JimorMarlow/Moonshine/README.md

# Moonshine
Temperature and water flow control

## Оборудование
- Датичики температуры DS18B20
    - (Tank) Температура внутри бака D8 с резьбой 1/2" 
    - (WaterOut) 2x Трехпроводные датчики для измерения температуры воды на выходе
        - df-out, °C
        - condenser-out, °C
    - 
- Датичики Холла для измерения потока воды (пока только счетчик срабатываний за 10с и за 1мин, без учета потока)
    - из дефлегматора (df)
    - из охладителя (condenser)
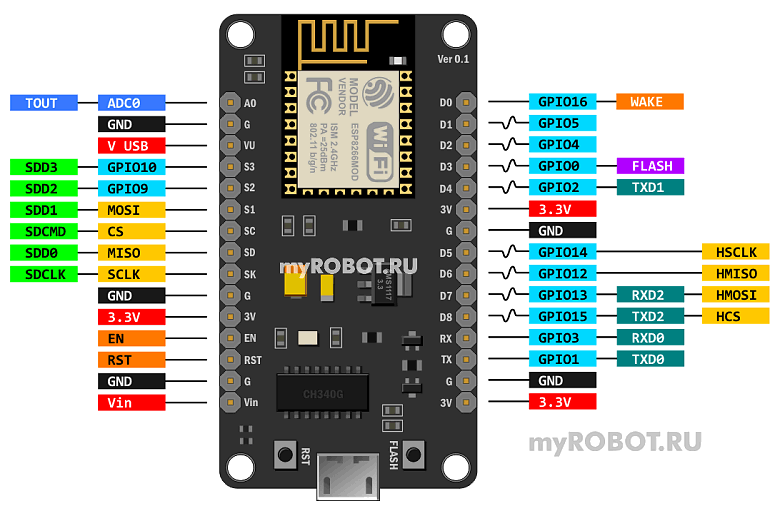
[picture p1: docs/nodemcu_v3_pinout.png]
NodeMCU v3 Pinout
- NodeMCU v3 Pinout <br>
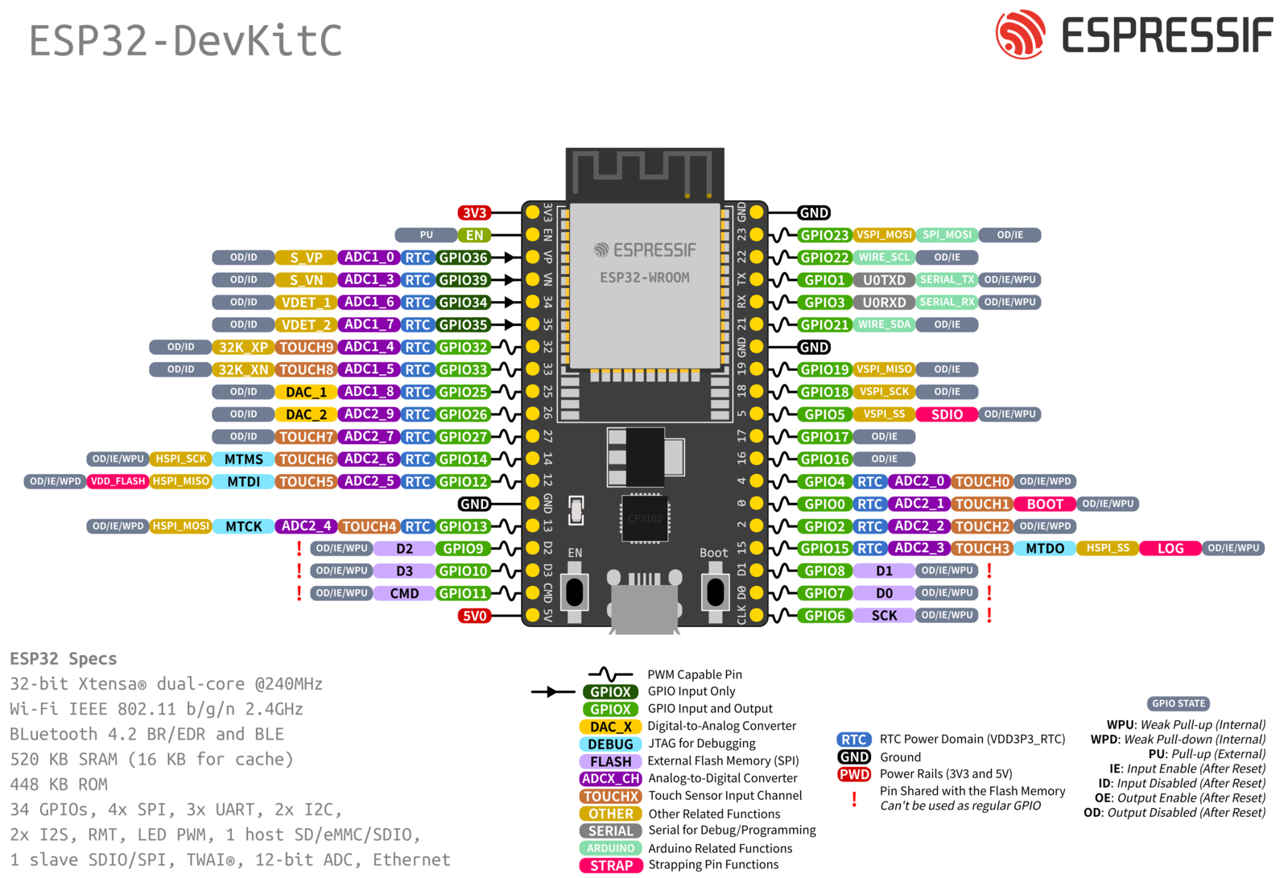
[picture p2: docs/images/eps32U-pinout.png]
ESP32-WROOM-32 Pinout
- ESP32-WROOM-32 Pinout <br>

## Названия переменных
- t_steam — Температура паров в верху колонны (после дефлегматора). Ключевая точка для контроля фракций.
- t_heater — Температура в нагревательном баке (кубе) с исходным материалом.
- t_deflegmator_water_out — Температура воды на выходе из дефлегматора. Показывает эффективность дефлегматора.
- t_condenser_water_out — Температура воды на выходе из охладителя (конденсатора/холодильника). Показывает эффективность конечного охлаждения.
- flow_deflegmator_water — Скорость потока воды через дефлегматор.
- flow_condenser_water — Скорость потока воды через охладитель (конденсатора/холодильника).

## Архитектура проекта
 
Основные компоненты:
ESP32-WROOM-32 (38pin) - взял с запасом, чтобы можно было подклчюить и графический дисплей, но потом оставил так

4 датчика температуры DS18B20 (водонепроницаемые, с цифровым интерфейсом OneWire). Один провод для всех датчиков + питание + земля.

Resistor 4.7kΩ между сигнальным проводом и питанием для подтяжки линии OneWire.

- D4 GPIO04 t_steam
- D5 GPIO05 t_heater
- D18 GPIO18 t_deflegmator_water_out
- D19 GPIO19 t_condenser_water_out

Примечание: не хочется возиться с адресами датчиков и их индексаций, буду подуключать датчики по одному на каждый пин и опрашивать отдельно, чтобы можно спокойно заменять датчики и точно знать, где какой

Для каждого датчика линию данных подтягиваем через 4.7kΩ Resistor к +3.3V
Все датчики на разных входах, чтобы можно было подключать любой датчик без настройки адресов 

### Датчик расхода воды

YF-S201 Не не подошел, слишком грубый.

Был подбран датчик для кофемашин с малыми потоками.
* Water Flow Sensor SEN-HZ06D

// ПРАВИЛЬНО - используем INPUT без дополнительной подтяжки
pinMode(FLOW_SENSOR_PIN, INPUT);  

Адаптация уровней напряжения:
SEN-HZ06D выдает 5V импульсы, а ESP32 работает с 3.3V логикой.
Используем 4-канальый конвертор логических уровней 5V-3V3

### 🔌 Сигнальные пины (GPIO) ESP32

| Пин на ESP32 | GPIO № | Куда идет (Компонент -> Пин) | Назначение / Примечание |
| :--- | :--- | :--- | :--- |
| **D21** | 21 | LCD2004 (`SDA`) | Шина I2C (данные) |
| **D22** | 22 | LCD2004 (`SCL`) | Шина I2C (тактирование) |
| **D15** | 15 | Кнопка (`1.l`) | Вход кнопки. В коде обязательно включить `INPUT_PULLUP` |
| **D4** | 4 | Датчик Steam (`DQ`) | Шина 1-Wire (пар) |
| **D5** | 5 | Датчик Heater (`DQ`) | Шина 1-Wire (нагреватель) |
| **D18** | 18 | Датчик DF (`DQ`) | Шина 1-Wire (дефлегматор) |
| **D19** | 19 | Датчик Cond (`DQ`) | Шина 1-Wire (конденсатор/холодильник) |
| **D32** | 32 | Преобразователь (`LV1`) | Сигнал от датчика потока `flowDF` (после понижения уровня) |
| **D33** | 33 | Преобразователь (`LV2`) | Сигнал от датчика потока `flowCond` (после понижения уровня) |

#### Схема коммутации

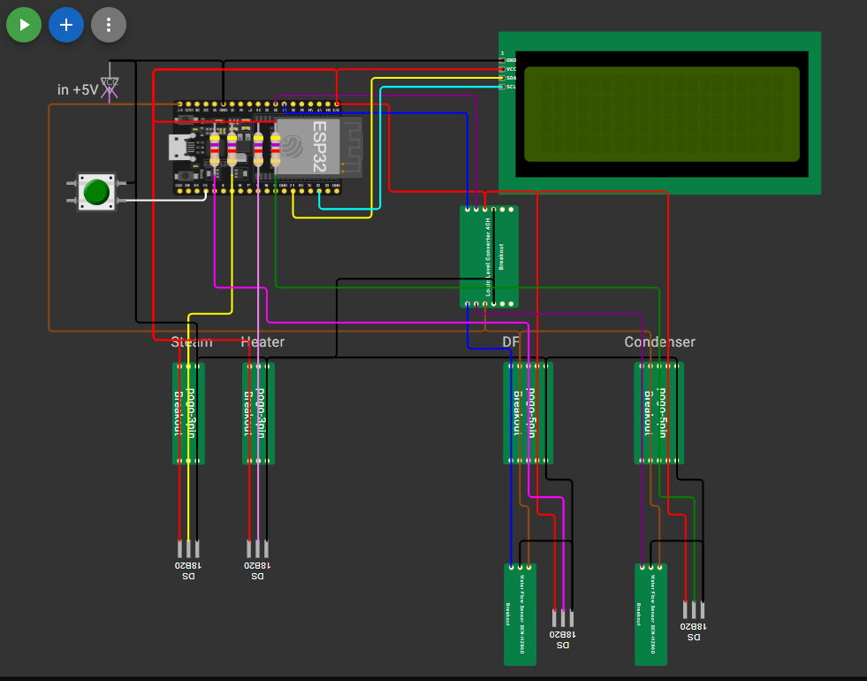
[picture p3: docs/wokwi/wire-esp32-v4.png]
ESP32-WROOM-32 Scheme
- ESP32-WROOM-32 Scheme <br>

### Распиновка контактов

#### 3-pin датчик с сигнальным
Рекомендованная разводка:

text
Разъем XH-2.54 3-pin (вид на плату):
       ┌─────┐
       │  ●  │ 1: GND      (Черный провод)
       │  ●  │ 2: 3V3      (Красный провод)  
       │  ●  │ 3: DATA     (Желтый провод)
       └─────┘
       
На плате (рядом с разъемом):
[GND] [3V3] [DATA]  ← шелкография
На принципиальной схеме:

text
Разъем J1 (DS18B20):
Pin 1: GND
Pin 2: 3V3
Pin 3: TEMP_DATA
5. Как определить правильную ориентацию:
Ключ (polarity key) на разъеме:
text
           ┌─────────┐
           │  КЛЮЧ   │ ← Выступ/защелка
           │   ▼     │
Контакты → │ ●  ●  ● │
           └─────────┘
           
Ключ всегда направлен:
- К началу (пину 1 - GND) ИЛИ
- К концу (пину 3 - DATA)
Распространенное правило: Ключ направлен к пину 1 (GND)

#### Комбирированный pogo 5-pin магнитный разъем для подключения датчика температуры и потока воды (дефлегматор и конденсер)
Магнитный раъъем на корпусе контроллера, снизу разделяется на два 3-pin водозащитных разъема.

Рекомендуемая распиновка для 5-pin магнитного разъема

Вид на разъем (на плате/в схеме):
Позиция датчиков в линии: [Датчик темп.]---[Датчик потока]
                          (ближе к плате)   (дальше)

##### РАЗЪЕМ 5-PIN:
┌─────┬─────┬─────┬─────┬─────┐
│  1  │  2  │  3  │  4  │  5  │
├─────┼─────┼─────┼─────┼─────┤
│ GND │ 3V3 │TEMP │ VCC │FLOW │
│     │     │DATA │(5V) │DATA │
└─────┴─────┴─────┴─────┴─────┘
     ↑     ↑     ↑     ↑     ↑
Общий   Для   Для     Для   Для
GND   DS18B20 DS18B20 Потока Потока

##### Обоснование:
- GND (пин 1) - общая земля для обоих датчиков
- 3V3 (пин 2) - питание температурного датчика DS18B20
- TEMP_DATA (пин 3) - данные температурного датчика
- VCC (пин 4) - питание 5V для датчика потока
- FLOW_DATA (пин 5) - данные датчика потока

##### На плате (PCB Layout):
- Метки шелкографии:
┌─────────────────────┐
│ DEFLEG/COND LINE    │
│  MAGNETIC CONNECTOR │
│                     │
│  1: GND  ⚫         │
│  2: 3V3  🔴         │
│  3: TEMP 🟡         │
│  4: 5V   🟤         │
│  5: FLOW 🔵         │
│                     │
│   ▲ KEY/MAGNET      │
└─────────────────────┘
- Цветовая маркировка проводов в кабеле:

##### Рекомендуемая цветовая схема:
┌─────┬───────┬──────────────┐
│ Пин │ Цвет  │ Назначение   │
├─────┼───────┼──────────────┤
│  1  │Черный │ GND (общий)  │
│  2  │Красный│ 3V3 (темп.)  │
│  3  │Желтый │ TEMP_DATA    │
│  4  │Коричневый│ 5V (поток) │
│  5  │Синий  │ FLOW_DATA    │
└─────┴───────┴──────────────┘

Преимущества:
Логическая группировка - сначала всё для температуры, потом для потока
Безопасность - GND первым, сигналы разделены питанием
Удобство отладки - цвета соответствуют функциям
Защита от ошибок - магнитный разъем + правильная полярность
На плате подпишите:

DEFLEG/COND LINE
[G] [3V] [T] [5V] [F]
▲ магнит/ключ

##### Защита и фильтрация:
На стороне платы (рядом с разъемом):

Добавьте:
- Конденсатор 100nF между 3V3 и GND (для DS18B20)
- Конденсатор 100nF между 5V и GND (для датчика потока)
- Резистор 4.7kΩ: TEMP_DATA → 3V3 (подтяжка OneWire)
- Резистор 10kΩ: FLOW_DATA → 3.3V (подтяжка на стороне ESP)
- Диод 1N4007 на линии 5V (защита от обратной полярности)

На стороне линии (в разветвителе):
В разветвителе добавьте:
- Еще по 100nF конденсатору у каждого датчика
- TVS диод на линии DATA (защита от статики)

## Links
### GyverDS18
https://github.com/GyverLibs/GyverDS18
### Принципиальная схема подключения DS18B20 к ESP8266
https://microkontroller.ru/esp8266-projects/podklyuchenie-datchika-temperatury-ds18b20-k-esp8266/

### Controlling Steam Valve with Arduino and Stepper Motor
https://arduinoexpert.com/controlling-steam-valve-with-arduino-and-stepper-motor/
- ➤ Stepper Motor to DRV8825
- ➤ DRV8825  
- ➤ 12V Power Supply:

### Размеры элементов на монтажной плате с шагом 2.54

- Монтажная плата основная      24x18
- ESP8266 NodeMCU               15x11
- BTN                           6x3
- 10pin cable                   5x2 (+1 во все стороны корпус)
- Конвертор логических уровней 4канала  6x5
- Монтажная плата для датчиков  28x6

### Version
#### 0.0.1
Добавил основу проекта, настроил библиотеки
#### 0.0.2
sensor_t - обвязка вокруг GyverDS18 для опроса датчиков температуры#### 0.#### 0.0.3
#### 0.0.3
Исправил опрос температуры, датчики можно переключать на ходу
#### 0.0.4
Подключил LCD 2004 для вывода температуры и времени работы
Добавил медианный (median3) фильтр для сглаживания температуры и вывожу только 1 знак после запятой.
#### 0.0.5
Изменил пины подключения, допаял колодку подключения;
Пока не работает делить для 5В датчика потока - отключил;
Добавил на S3 сенсорную кнопку для отладки.
Небольшая оптимизация кода и вывода на экран.

#### 0.0.6-0.0.10
- Изменил пины, подобрал все входы. чтобы работали датчики. кнопка запуска калибровки датчиков расхода воды. и не мешало запуску и работе ESP8266&.
- Убрал делители напряжения и поставил 4 канальный согласователь логических уровней 3.3V-5V. Теперь датчик холла нормально работает на 5В и не превышает допустимые уровни.
- Собрал первую рабочую схему с полным набором датчиков в конфигурации:
    - S: температура в верхней части колонны (главный контроль отбора фракций)
    - D: температура и счетчик потока воды на выходе из дефлегматоре (больше для контроля и калибровки модифицированнго YF-S201 датчика). В среднем расход 2 мин/1 л (~30L/min). Можно заменить на YF-S401 - его чувствительности должно хватать без модификаций
    - C: температура и счетчик потока воды на выходе из кондесера. Датчик YF-S401 часто простаивает из-за малого потока (13 мин / 1 л, ~5L/min). Нужен более чувствительный датчик.
    - H: температура в нагревательном баке (контроль мощности плиты)
- Сделал режим калибровки. При нажатии на кнопку оба датчика расхода воды сбрасываются и начинают считать время и количество пульсов датчика Холла. Второе нажатие отключает калибровку и покахывает итоговые результаты. Они нужны для составления таблицы и дальнейшего расчета потока воды на разных скоростях потока воды, чтобы учесть неравномерность работы датчика на малых расходах и индивидуальные особенности конкретного датчика.
- Вся схема собрана на макетной плате и бредборде на перемычках. Продумать реализацию автоматической регулировки игольчатого крана с помощью шагового двигателя. После отладки автоматизации развести плату для чистовой пайки и напечатать модель корпуса.
- Перекоммутировал трубки для воды и расположение игольчатых кранов. чтобы локализовать все в одном месте рядом с расбором воды и освободить место для датчиков.
- Выполнил первую дистиляцию с электронным контролем температуры без аналоговых датчиков;

#### 1.0.x
- Изменил заглавную "C" на строчную "c", чтобы не отвлекало от значений.
- Уменьшил скорость индикатора потока на порядок для более плавной анимации. Возможно, нужно будет еще сделать меньше.
- Купил более чувствительные датчики потока "SEN-HZ06D DC5V Small Size Mini Water Flow Sensor Fluid Flow Meter Switch 0.05-1.5L/min For Coffee Machine", буду добавлять в макет
https://ali.click/ktwszq
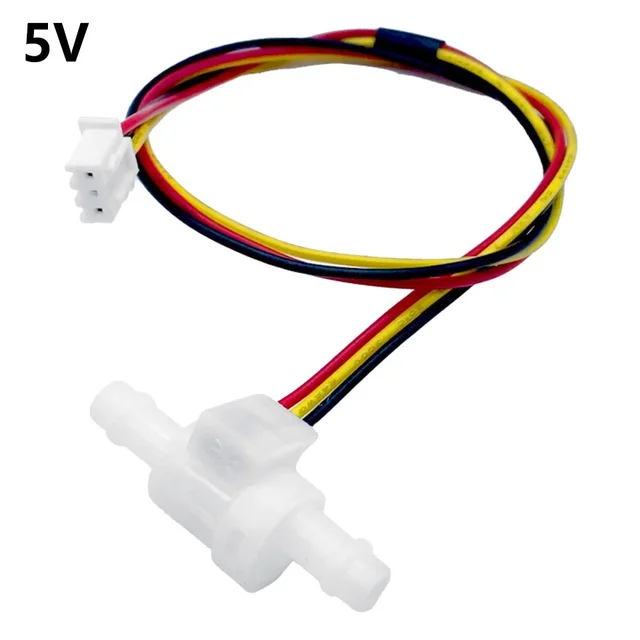
[picture p4: docs/SEN-HZ06D DC5V Small Size Mini Water Flow Sensor Fluid Flow Meter Switch 0.05-1.5L-min.webp]
SEN-HZ06D
<br>
- С помощью qwen 3.5 сделал макет Web-UI для показа текущего состояния [qwen-distillation](docs\web-ui\qwen-distillation.021.html)
- Сделал первый макет разводки PCB платы в EasyEDA. Вместо датчика температуры 3pin и датчика потока 3pin принял решение делать комбинированный pogo 5pin разъем.
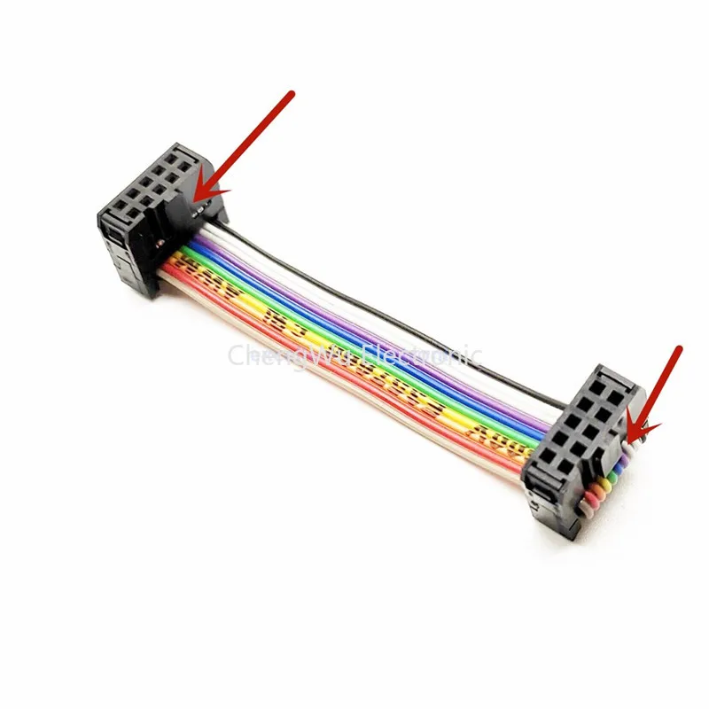
[picture p5: docs/DC3_10p_connector_x2.webp]
DC3_10p_connector_x2
- для соединения основной платы и контактной панели с разъемами для датчиков планирую использовать двойной 10pin шлейф <br>

#### 1.0.31 Добавил макет web-ui с помощью qwen 3.5
Инструкция по установке docs\qwen_install.md

#### 1.1.1 settings::moonshine::state_t
Начал оборачивать все данные в нормальные структуры...

#### 1.2.3 Исправление mDNS
Исправлена работа mDNS для доступа по http://moonshine.local:
- Добавлен вызов `MDNS.update()` в цикле обработки клиентов
- Исправлен порядок инициализации WiFi (hostname до mode)
- Без этого mDNS служба не отвечала на запросы после запуска

#### 1.2.0 Web UI для ESP8266
Добавлен веб-интерфейс для мониторинга процесса дистилляции:
- **Платформа:** ESP8266 (NodeMCU v3)
- **Режимы работы:**
  - Точка доступа (AP): `Moonshine_AP` / `moonshine123`
  - Подключение к Wi-Fi сети (STA)
  - Комбинированный режим (STA+AP)
- **mDNS:** http://moonshine.local (при подключении к Wi-Fi)
- **Обновление данных:** 500ms через AJAX
- **Файлы:**
  - `src/web-ui.h` — объявление веб-сервера
  - `src/web-ui.cpp` — реализация сервера с HTML шаблоном
  - `src/main_ui.cpp` — пример инициализации
- **API:**
  - `GET /` — HTML страница мониторинга
  - `GET /api/state` — JSON с текущими показаниями датчиков
  - `GET /api/status` — JSON со статусом системы (uptime, режим, IP)
- **Данные:** Используются из `settings::moonshine::state_t`
- **Версия веб-интерфейса:** Синхронизирована с `MS_VERSION_STRING` из `version.h`

##### Использование:
```cpp
#include "web-ui.h"

settings::moonshine::state_t get_state(); // Ваша функция получения данных

webui::MoonshineWebServer webServer;

void setup() {
    webServer.setStateGetter(get_state);
    webServer.begin();
}

void loop() {
    webServer.handleClient();
}
```
#### 1.3.1 Переход на ESP32-WROOM - fixes

web-ui - updated to ESP32/ESP8266 compatibility

#### 1.3.0 Переход на ESP32-WROOM

- Заменил чип, чтобы было больше разъемов и можно было подключить графический экран потом с энкодером
- Сделал схему в wokwi https://wokwi.com/projects/478560883984119809
- Схема подключения: 
    - docs\wokwi\wokwi-Moonshine_02.zip
    - docs\wokwi\wire-esp32-v2.png

#### 1.3.- Поменял схему подключения ESP32-WROOM и файл readme.md

На память - информация о подключении графического дисплея
docs\ST7789 320x240 EC11 Rotary Encoder Button.md
