JimorMarlow/Moonshine/docs/cable-pinouts.md

## Цветовая маркировка шлейфа IDC (10 pin / 2x5)

Для 10-контактного шлейфа используется стандартная «радужная» маркировка. Цвета идут в последовательности цветов резисторов, начиная от контакта №1.

### 🎨 Стандартная последовательность цветов

| Маркер | Номер контакта (Pin) | Цвет провода | Подключение |
| :---: | :--- | :--- | :--- |
| 🟤 | **1** | **Коричневый** | 5V |
| 🔴 | **2** | **Красный** | 3V3 |
| 🟠 | **3** | **Оранжевый** | T_STEAM |
| 🟡 | **4** | **Жёлтый** | T_HEATER |
| 🟢 | **5** | **Зелёный** | T_DF |
| 🔵 | **6** | **Синий** | T_CONDENSER |
| 🟣 | **7** | **Фиолетовый** | FLOW_DF |
| <span style="color:#808080">█</span> | **8** | **Серый** | FLOW_CONDENSER |
| ⚪ | **9** | **Белый** | BTN |
| ⚫ | **10** | **Чёрный** | GND |

PS. Вместо серого используется блок, так как серого кружочка нет в Unicode

### 📊 Распределение контактов по рядам (2x5)

В двухрядном разъеме 10-pin контакты нумеруются «змейкой» (нечетные в одном ряду, четные — в другом):

```text
       Ряд 1:  [Pin 1: Коричневый] [Pin 3: Оранжевый] [Pin 5: Зелёный] [Pin 7: Фиолетовый] [Pin 9: Белый]
       Ряд 2:  [Pin 2: Красный]    [Pin 4: Жёлтый]    [Pin 6: Синий]   [Pin 8: Серый]      [Pin 10: Чёрный]
                     ▲
              Метка Pin 1 (ключ / стрелка / треугольник)
```

### 🔍 Как найти Pin 1 (первый контакт)

На корпусе разъема ищите один из следующих маркеров:
1.  **Треугольник** или **стрелку**, выдавленную на пластике.
2.  **Ключ** (выступ) — обычно Pin 1 находится рядом с ним или на стороне, противоположной вырезу.
3.  Если шлейф серый, крайний провод, помеченный **красной полосой**, всегда является Pin 1. В разноцветном шлейфе — это **коричневый** провод.

> ⚠️ **Важно:** При пайке ответного разъема на плату обязательно сверяйтесь с даташитом или шелкографией платы. Иногда производители плат нумеруют контакты построчно (сначала 1-5, затем 6-10), а не «змейкой» (1-3-5 / 2-4-6), как в стандартном разъеме. Внимательная проверка схемы спасет от перепутывания питания и сигнальных линий.
```
