JimorMarlow/Moonshine/docs/ST7789 320x240 EC11 Rotary Encoder Button.md

## Замена LCD2004 на графический дисплей ST7789 320x240 EC11 Rotary Encoder Button

- ST7789 320x240 <br>ST7789+Encoder

https://ali.click/9kmoo1r

На фотографии изображен отличный комбинированный модуль: это цветной дисплей (судя по маркировке пинов и чипу, это 1.8-дюймовый SPI-экран ST7735 или аналогичный), на плате которого уже распаяны инкрементальный энкодер и одна отдельная тактовая кнопка (KEY0).
Это идеальное решение, потому что вся лицевая панель вашего устройства собирается на одной плате, а к вашей основной макетке 5×7 см она будет подключаться всего через один общий 12-пиновый разъем (ряд контактов сверху модуля).
Давайте разберем распиновку этого модуля и схему его подключения к вашей ESP32.

📝 1. Расшифровка пинов модуля (12-pin разъем)

Слева направо (согласно маркировке на фото):
1. GND — Общий минус питания.
2. VDD — Плюс питания (3.3V, так как дисплей и логика ESP32 работают на этом напряжении).
3. SCL — Тактовая частота шины SPI (обычно обозначается как SCK или CLK).
4. SDA — Данные шины SPI (обычно обозначается как MOSI или SDI).
5. RES — Сброс экрана (Reset).
6. DC — Режим Команда/Данные (Data/Command или RS).
7. CS — Выбор чипа экрана (Chip Select).
8. BLK — Управление подсветкой дисплея.
9. TRA — Выход фазы А энкодера (CLK).
10. TRB — Выход фазы В энкодера (DT).
11. PSH — Выход встроенной кнопки энкодера при нажатии (Switch / SW).
12. KEY0 — Выход отдельной тактовой кнопки, расположенной снизу под энкодером.

🗺️ 2. Куда подключать на ESP32 (Новая безопасная карта пинов)

Поскольку шина I2C (D21, D22) от старого LCD2004 полностью освободилась, мы перенаправим её на этот модуль. Для аппаратного SPI используем шину VSPI.
Чтобы не пересекаться с вашими датчиками потока и температуры, подключайте 12-pin разъем к ESP32 по следующей схеме:

Пин модуля	Назначение	Пин на ESP32	Примечание в коде / Настройка
GND	Земля	GND	На общую шину земли платы
VDD	Питание 3.3V	3V3	На общую шину 3.3V
SCL	SPI Clock	D18	Внимание: Перенесите датчик температуры DF (дефлегматор) с D18 на свободный безопасный D2.
SDA	SPI MOSI	D23	Стандартный аппаратный пин VSPI (полностью свободен)
RES	Экран Reset	D22	Свободный пин (бывший I2C SCL)
DC	Экран Data/Cmd	D21	Свободный пин (бывший I2C SDA)
CS	Экран Chip Sel.	D5	Внимание: Перенесите датчик температуры Heater с D5 на свободный безопасный D14.
BLK	Подсветка	3V3	Можно просто припаять к шине 3.3V, чтобы экран горел всегда на 100%.
TRA	Энкодер А	D25	Свободный пин (поддерживает прерывания)
TRB	Энкодер В	D26	Свободный пин (поддерживает прерывания)
PSH	Кнопка энкодера	D27	Свободный пин. В коде настроить как INPUT_PULLUP
KEY0	Нижняя кнопка	D13	Свободный пин. В коде настроить как INPUT_PULLUP

Примечание: Старая отдельная кнопка на D15 из вашей прошлой таблицы остается на своем месте, а кнопка KEY0 на самом модуле дисплея дает вам дополнительный орган управления (например, кнопку "Назад" или "Старт/Стоп").

# Паспорт проекта: Карта подключений ESP32 (38-pin)

Актуальная таблица подключений всех компонентов автоматики с учетом комбинированного SPI-дисплея со встроенным энкодером, независимых датчиков температуры (1-Wire), датчиков потока воды и внешнего управления. 

Все конфликты пинов устранены, шина SPI переведена на аппаратный контроллер `VSPI`, а температурные датчики перенесены на безопасные выводы (`D2`, `D14`).
---

### 📊 Итоговая таблица распиновки ESP32 (38-pin)

| Пин на ESP32 | GPIO № | Куда идет (Компонент -> Пин) | Назначение / Настройка в коде |
| :--- | :---: | :--- | :--- |
| **🔌 Силовые выводы** | | | |
| **5V / VIN** | — | Винтовой клеммник XY301V (`+`) | Вход основного питания платы +5В от сети |
| **3V3** | — | Модуль дисплея (`VDD`), Конвертер (`LV`), Резисторы | Выход встроенного стабилизатора 3.3В для логики |
| **GND** | — | Клеммник (`-`), Дисплей (`GND`), Конвертер (`GND`) | Общая шина заземления схемы (Земля) |
| **🖥️ Интерфейс Дисплея и Энкодера (SPI + GPIO)** | | | |
| **D18** | 18 | Модуль дисплея (`SCL` / SCK) | Шина VSPI (Тактирование экрана) |
| **D23** | 23 | Модуль дисплея (`SDA` / MOSI) | Шина VSPI (Данные экрана) |
| **D22** | 22 | Модуль дисплея (`RES`) | Сброс экрана (`Reset`) |
| **D21** | 21 | Модуль дисплея (`DC`) | Выбор режима Команда/Данные экрана |
| **D5** | 5 | Модуль дисплея (`CS`) | Выбор чипа экрана (`Chip Select`) |
| **D25** | 25 | Модуль дисплея (`TRA`) | Фаза А энкодера (Настройка: `INPUT` + прерывание) |
| **D26** | 26 | Модуль дисплея (`TRB`) | Фаза В энкодера (Настройка: `INPUT` + прерывание) |
| **D27** | 27 | Модуль дисплея (`PSH`) | Встроенная кнопка энкодера (Настройка: `INPUT_PULLUP`) |
| **D13** | 13 | Модуль дисплея (`KEY0`) | Дополнительная кнопка на модуле (Настройка: `INPUT_PULLUP`) |
| **🌡️ Датчики температуры (1-Wire, подтяжка 4.7 кОм к 3.3В)** | | | |
| **D4** | 4 | Датчик Steam (`DQ`) | Температура пара (Пар) |
| **D14** | 14 | Датчик Heater (`DQ`) | Температура нагревателя (Перенесен с D5) |
| **D2** | 2 | Датчик DF (`DQ`) | Температура дефлегматора (Перенесен с D18) |
| **D19** | 19 | Датчик Cond (`DQ`) | Температура конденсатора / холодильника |
| **🌊 Датчики потока воды (Через логический конвертер 5В -> 3.3В)** | | | |
| **D32** | 32 | Конвертер уровней (`LV1`) | Сигнал от датчика потока `flowDF` |
| **D33** | 33 | Конвертер уровней (`LV2`) | Сигнал от датчика потока `flowCond` |
| **🎛️ Внешнее управление** | | | |
| **D15** | 15 | Отдельная выносная кнопка | Основная кнопка управления (Настройка: `INPUT_PULLUP`) |

---

### 💡 Важные примечания для написания прошивки

1. **Библиотека дисплея (ST7735):** 
   Для работы с цветным экраном в среде разработки (Arduino IDE / PlatformIO) используйте официальные библиотеки `Adafruit_GFX.h` и `Adafruit_ST7735.h`. 
   Инициализация в коде выполняется следующим образом:
   ```cpp
   #define TFT_CS   5
   #define TFT_DC  21
   #define TFT_RST 22
   // Пины MOSI (23) и SCK (18) библиотека задействует аппаратно сами
   Adafruit_ST7735 tft = Adafruit_ST7735(TFT_CS, TFT_DC, TFT_RST);
   ```

2. **Плавная работа энкодера:** 
   Чтобы считывать вращение ручки энкодера без рывков и пропусков шагов во время отрисовки интерфейса, используйте библиотеку `Encoder.h` от Paul Stoffregen. Она автоматически повесит обработку сигналов на высокоскоростные аппаратные прерывания пинов `D25` и `D26`.

3. **Управление подсветкой (BLK):** 
   На 12-пиновом разъеме модуля контакт `BLK` припаивается напрямую к силовой шине `3V3`, чтобы подсветка работала постоянно на 100%. Если в будущем вам потребуется программно гасить экран по таймеру или управлять его яркостью, этот провод можно будет перебросить на любой свободный ШИМ-пин ESP32 (например, полностью свободный `D12`).

4. **Датчики DS18B20:** 
   Для работы с температурными датчиками используйте библиотеки `OneWire.h` и `DallasTemperature.h`. В коде под каждый датчик создается свой экземпляр OneWire на соответствующем пине (4, 14, 2, 19).
