JimorMarlow/Moonshine/docs/wokwi/wowki-moonshine.md

# Разработка схемы подключения элементов

https://wokwi.com/projects/478560883984119809

- Замена ESO8266 на ESP32-WROOM-32U

## TODO (DeekSeek)

Раз вы решили подключить всё вручную (что в данном случае — самое надежное решение), я подготовил для вас **пошаговую таблицу подключений** и обновил файл `diagram.json`, добавив внешнее питание.

### 🔌 Обновленный файл `diagram.json` (с внешним питанием)

Замените ваш код на этот. Я добавил источники питания (`vcc5V` и `gnd1`) и разместил их над ESP32. **Я специально удалил массив `"connections"` (оставив только монитор порта), чтобы вы могли соединить всё сами в визуальном редакторе**, кликая от пина к пину.

```json
{
  "version": 1,
  "author": "Anonymous maker",
  "editor": "wokwi",
  "parts": [
    { "type": "wokwi-vcc", "id": "vcc5V", "top": -200, "left": -50, "attrs": { "voltage": "5" } },
    { "type": "wokwi-gnd", "id": "gnd1", "top": -100, "left": -50, "attrs": {} },
    
    { "type": "board-esp32-devkit-c-v4", "id": "esp", "top": 50, "left": 0, "attrs": {} },
    
    { "type": "wokwi-lcd2004", "id": "lcd", "top": -150, "left": 200, "attrs": { "pins": "i2c" } },
    { "type": "wokwi-pushbutton", "id": "btn1", "top": -150, "left": -200, "attrs": { "color": "yellow", "xray": "1" } },
    { "type": "chip-logic-level-converter", "id": "level", "top": 50, "left": 350, "attrs": {} },
    
    { "type": "wokwi-ds18b20", "id": "tempSteam", "top": 200, "left": -250, "attrs": {} },
    { "type": "wokwi-resistor", "id": "resSteam", "top": 200, "left": -180, "rotate": 90, "attrs": { "value": "4.7k" } },
    
    { "type": "wokwi-ds18b20", "id": "tempHeater", "top": 300, "left": -250, "attrs": {} },
    { "type": "wokwi-resistor", "id": "resHeater", "top": 300, "left": -180, "rotate": 90, "attrs": { "value": "4.7k" } },
    
    { "type": "wokwi-ds18b20", "id": "tempDF", "top": 200, "left": 150, "attrs": { "deviceID": "DF" } },
    { "type": "wokwi-resistor", "id": "resDF", "top": 200, "left": 80, "rotate": 90, "attrs": { "value": "4.7k" } },
    
    { "type": "wokwi-ds18b20", "id": "tempCond", "top": 300, "left": 150, "attrs": { "deviceID": "Condenser" } },
    { "type": "wokwi-resistor", "id": "resCond", "top": 300, "left": 80, "rotate": 90, "attrs": { "value": "4.7k" } },
    
    { "type": "chip-flow-sensor", "id": "flowDF", "top": 200, "left": 400, "attrs": {} },
    { "type": "chip-flow-sensor", "id": "flowCond", "top": 350, "left": 400, "attrs": {} }
  ],
  "connections": [
    [ "esp:TX", "$serialMonitor:RX", "", [] ],
    [ "esp:RX", "$serialMonitor:TX", "", [] ]
  ],
  "dependencies": {}
}
```

---

### 📋 Таблица подключений (для ручной сборки)

В Wokwi, чтобы соединить провода, нужно **кликнуть по пину** одного компонента, а затем **кликнуть по пину** другого. Цвет провода появится автоматически (или его можно поменять, кликнув на него).

Обратите внимание: земля (`GND`) у нас теперь общая. На схеме это компонент `gnd1`. Питание `5V` для силовой части идет от `vcc5V`.

#### 1. Питание ESP32 (Внешнее)
*Чтобы ESP32 запитался от нашего блока питания.*
* `vcc5V` (пин **VCC**) ↔ `esp` (пин **5V**)
* `gnd1` (пин **GND**) ↔ `esp` (пин **GND.1**)

#### 2. Дисплей LCD2004
* `esp` (пин **3V3**) ↔ `lcd` (пин **VCC**)
* `gnd1` (пин **GND**) ↔ `lcd` (пин **GND**)
* `esp` (пин **D21**) ↔ `lcd` (пин **SDA**)
* `esp` (пин **D22**) ↔ `lcd` (пин **SCL**)

#### 3. Кнопка (BTN)
* `esp` (пин **D15**) ↔ `btn1` (пин **1.l**)
* `gnd1` (пин **GND**) ↔ `btn1` (пин **2.l**)

#### 4. Датчики температуры (DS18B20) — *все 4 штуки*
*Будьте внимательны: для каждого датчика нужно 5 соединений (включая резистор).*
**Датчик Steam (Пар):**
* `esp` (пин **3V3**) ↔ `tempSteam` (пин **VCC**)
* `gnd1` (пин **GND**) ↔ `tempSteam` (пин **GND**)
* `esp` (пин **D4**) ↔ `tempSteam` (пин **DQ**) ↔ `resSteam` (пин **2**)
* `esp` (пин **3V3**) ↔ `resSteam` (пин **1**)

**Датчик Heater (Нагреватель):**
* `esp` (пин **3V3**) ↔ `tempHeater` (пин **VCC**)
* `gnd1` (пин **GND**) ↔ `tempHeater` (пин **GND**)
* `esp` (пин **D5**) ↔ `tempHeater` (пин **DQ**) ↔ `resHeater` (пин **2**)
* `esp` (пин **3V3**) ↔ `resHeater` (пин **1**)

**Датчик DF (Дефлегматор):**
* `esp` (пин **3V3**) ↔ `tempDF` (пин **VCC**)
* `gnd1` (пин **GND**) ↔ `tempDF` (пин **GND**)
* `esp` (пин **D18**) ↔ `tempDF` (пин **DQ**) ↔ `resDF` (пин **2**)
* `esp` (пин **3V3**) ↔ `resDF` (пин **1**)

**Датчик Cond (Конденсатор):**
* `esp` (пин **3V3**) ↔ `tempCond` (пин **VCC**)
* `gnd1` (пин **GND**) ↔ `tempCond` (пин **GND**)
* `esp` (пин **D19**) ↔ `tempCond` (пин **DQ**) ↔ `resCond` (пин **2**)
* `esp` (пин **3V3**) ↔ `resCond` (пин **1**)

#### 5. Преобразователь уровней (Logic Level Converter)
*Для него нужно два питания: 3.3В (низкая сторона) и 5В (высокая сторона).*
* `vcc5V` (пин **VCC**) ↔ `level` (пин **HV**) — *силовое питание*
* `esp` (пин **3V3**) ↔ `level` (пин **LV**) — *логическое питание*
* `gnd1` (пин **GND**) ↔ `level` (пин **GND1**)
* `gnd1` (пин **GND**) ↔ `level` (пин **GND2**) *(если у чипа два пина GND)*

#### 6. Датчики потока (Flow Sensors)
*Обратите внимание: они питаются от 5В!*
**Датчик flowDF:**
* `vcc5V` (пин **VCC**) ↔ `flowDF` (пин **VCC**)
* `gnd1` (пин **GND**) ↔ `flowDF` (пин **GND**)
* `flowDF` (пин **SIG**) ↔ `level` (пин **HV1**) — *сигнал на высокую сторону*
* `esp` (пин **D32**) ↔ `level` (пин **LV1**) — *сигнал на низкую сторону*

**Датчик flowCond:**
* `vcc5V` (пин **VCC**) ↔ `flowCond` (пин **VCC**)
* `gnd1` (пин **GND**) ↔ `flowCond` (пин **GND**)
* `flowCond` (пин **SIG**) ↔ `level` (пин **HV2**) — *сигнал на высокую сторону*
* `esp` (пин **D33**) ↔ `level` (пин **LV2**) — *сигнал на низкую сторону*

---
**Совет по сборке:** Начните с подключения земли (`gnd1`) ко всем компонентам, у которых есть GND (LCD, кнопка, датчики температуры, преобразователь, датчики потока). Затем разведите питание (3.3В на слаботочку, 5В на датчики потока и HV-часть). И в самом конце подключите сигнальные провода (D4, D5, D15, D18, D19, D21, D22, D32, D33). Так вы точно ничего не перепутаете!

## Схема подключения

2026-10-22
- docs\wokwi\wokwi-Moonshine_02.zip
- docs\wokwi\wire-esp32-v2.png

## esp32 pinout

Вот подробная таблица подключений, привязанная конкретно к выводам вашей платы ESP32 (DevKit C V4). 

Я добавил колонку с **номером GPIO**, так как в коде прошивки (в Arduino IDE) вы будете обращаться к пинам именно по этим номерам, а не по буквам `Dxx`.

### ⚡ 1. Питание и Земля (Power & Ground)

| Пин на ESP32 | Куда идет | Описание |
| :--- | :--- | :--- |
| **5V** (или VIN) | `vcc5V` (блок питания) | Вход внешнего питания 5В. Отсюда же питаются датчики потока и HV-часть преобразователя. |
| **3V3** | LCD (`VCC`), Датчики t (`VCC`), Преобразователь (`LV`), Резисторы (`1`) | Выход стабилизатора ESP32 (3.3В). Питает слаботочную логику и датчики температуры. |
| **GND.1** | Все компоненты (`GND`) | Общая земля. Рекомендую соединить все земли именно с этим пином (или с внешним `gnd1`). |

---

### 🔌 2. Сигнальные пины (GPIO)

| Пин на ESP32 | GPIO № | Куда идет (Компонент -> Пин) | Назначение / Примечание |
| :--- | :--- | :--- | :--- |
| **D21** | 21 | LCD2004 (`SDA`) | Шина I2C (данные) |
| **D22** | 22 | LCD2004 (`SCL`) | Шина I2C (тактирование) |
| **D15** | 15 | Кнопка (`1.l`) | Вход кнопки. В коде обязательно включить `INPUT_PULLUP` |
| **D4** | 4 | Датчик Steam (`DQ`) | Шина 1-Wire (пар) |
| **D5** | 5 | Датчик Heater (`DQ`) | Шина 1-Wire (нагреватель) |
| **D18** | 18 | Датчик DF (`DQ`) | Шина 1-Wire (дефлегматор) |
| **D19** | 19 | Датчик Cond (`DQ`) | Шина 1-Wire (конденсатор/холодильник) |
| **D32** | 32 | Преобразователь (`LV1`) | Сигнал от датчика потока `flowDF` (после понижения уровня) |
| **D33** | 33 | Преобразователь (`LV2`) | Сигнал от датчика потока `flowCond` (после понижения уровня) |

---

### 💡 Полезная шпаргалка для кода

Когда будете писать код, объявление пинов будет выглядеть примерно так:

```cpp
// Дисплей и кнопка
#define I2C_SDA 21
#define I2C_SCL 22
#define BTN_PIN 15 // Не забыть pinMode(BTN_PIN, INPUT_PULLUP);

// Датчики температуры (1-Wire)
#define TEMP_STEAM_PIN 4
#define TEMP_HEATER_PIN 5
#define TEMP_DF_PIN 18
#define TEMP_COND_PIN 19

// Датчики потока (прерывания)
#define FLOW_DF_PIN 32
#define FLOW_COND_PIN 33
```

**Важный нюанс по датчикам потока (D32, D33):** 
Эти пины отлично подходят для чтения импульсов, так как поддерживают аппаратные прерывания (interrupts). В коде вы сможете использовать `attachInterrupt(digitalPinToInterrupt(FLOW_DF_PIN), pulseCounterFunction, RISING);`, чтобы точно считать частоту вращения крыльчатки без пропусков.

🧮 Рекомендуемая распиновка разъема JTAG-10P

Чтобы минимизировать перекрещивание дорожек на плате и сделать шлейф безопасным (разнести питание и данные), используйте следующую карту пинов для разъема 2×5:

Пин разъема	Сигнал (Цвет / Датчик)	Куда вести дорожку на макетке
Пин 1	GND (Черный)	На общую шину GND платы
Пин 2	3V3 (Красный)	На общую шину 3.3V (питание DS18B20)
Пин 3	5V (Коричневый)	На общую шину 5V от DC-IN (питание датчиков потока)
Пин 4	Кнопка (Белый)	На пин D15 верхней планки ESP32
Пин 5	Датчик Steam (D4)	На пин D4 верхней планки ESP32 (+ к его резистору)
Пин 6	Датчик Heater (D5)	На пин D5 верхней планки ESP32 (+ к его резистору)
Пин 7	Датчик DF (D18)	На пин D18 верхней планки ESP32 (+ к его резистору)
Пин 8	Датчик Cond (D19)	На пин D19 верхней планки ESP32 (+ к его резистору)
Пин 9	Датчик потока flowDF	На пин HV1 конвертера уровней
Пин 10	Датчик потока flowCond	На пин HV2 конвертера уровней
