JimorMarlow/Moonshine/docs/web-ui/errors/screenshot_028.png

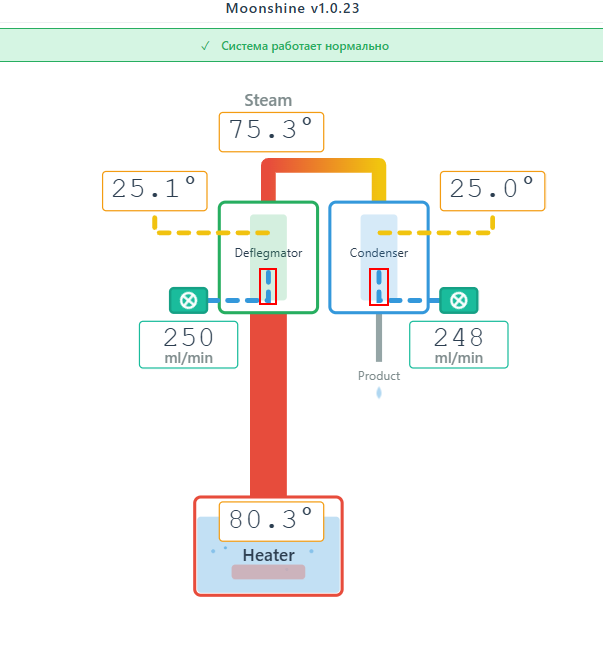
docs/web-ui/errors/screenshot_028.png
