JimorMarlow/Moonshine/docs/wokwi/wire-esp32-v2.png

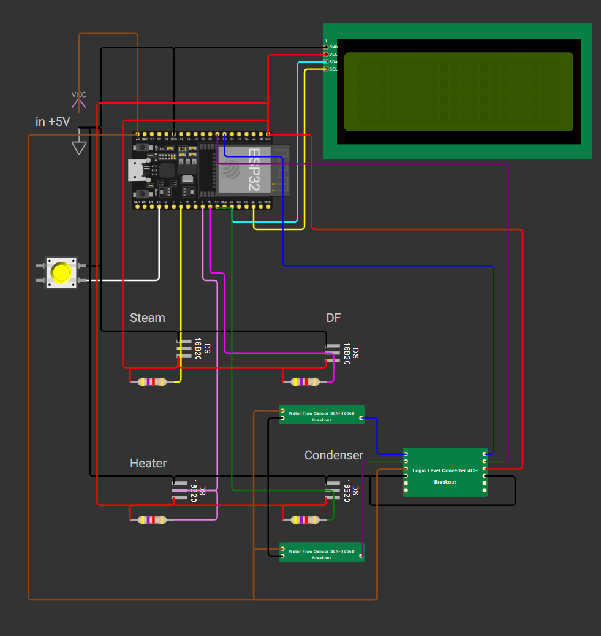
docs/wokwi/wire-esp32-v2.png
