JimorMarlow/Moonshine/docs/wokwi/wire-esp32-v3.png

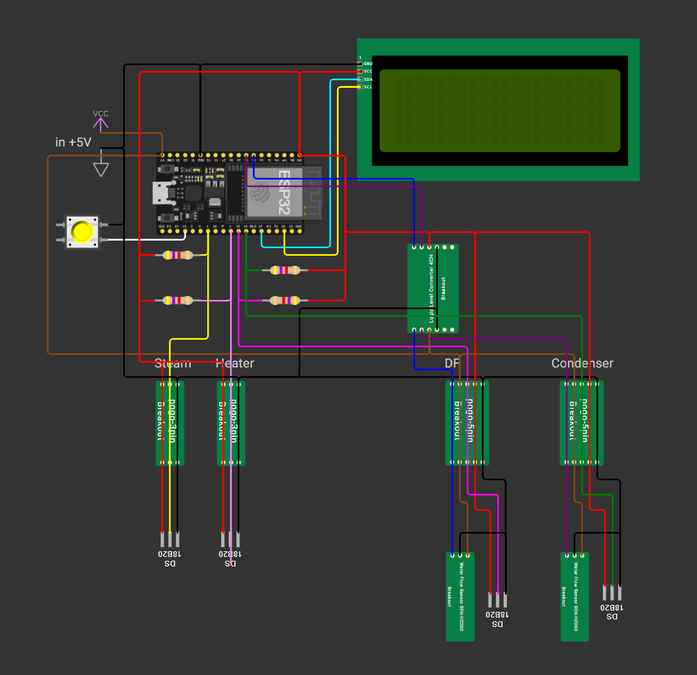
docs/wokwi/wire-esp32-v3.png
