JimorMarlow/Moonshine/docs/OpenSCAD/end-cap-20x10_v1.stl

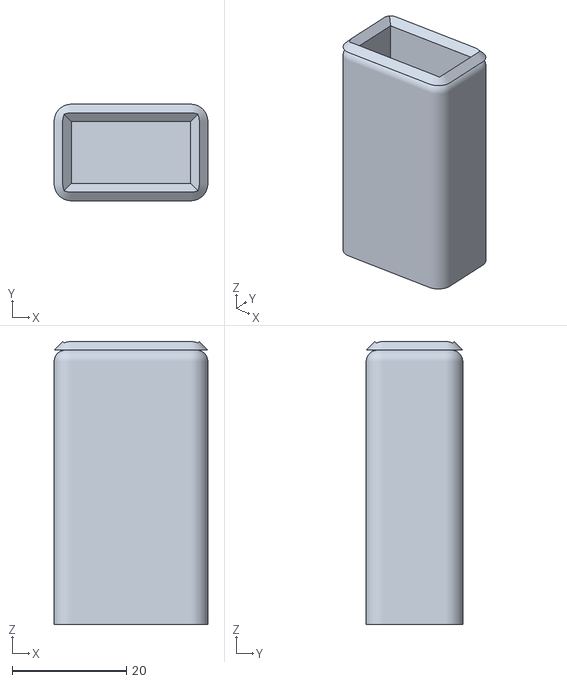
[picture p9: CAD file, 2026-10-28]
docs/OpenSCAD/end-cap-20x10_v1.stl
26.9 x 16.9 x 49.5
