JimorMarlow/Moonshine/docs/OpenSCAD/flow-sensor-adpter-6-8mm.stl

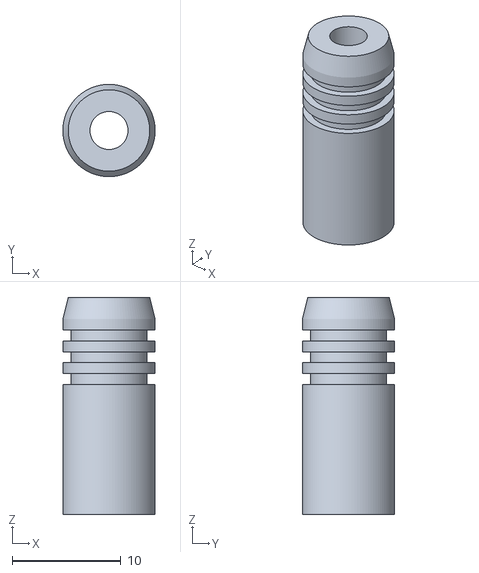
[picture p10: CAD file, 2026-10-27]
docs/OpenSCAD/flow-sensor-adpter-6-8mm.stl
8.50 x 8.50 x 20.0
