JimorMarlow/Moonshine/docs/web-ui/task_wifi_setup_design.md

# WiFi Setup Page — Техническое задание

**Версия:** ESP Device v1.0.0

## Описание задачи

Разработать веб-интерфейс для первичной настройки WiFi подключения устройства на базе ESP8266/ESP32.

## Контекст

Устройство имеет два режима работы:
1. **Режим настройки (Setup Mode)** — точка доступа с именем `ESP_Device_AP` для первичной конфигурации
2. **Рабочий режим (Station Mode)** — подключение к домашней WiFi сети с доступом по mDNS `espdevice.local`

## Требования к дизайну

### 1. Контейнер информации об устройстве (Device Info Container)

**Расположение:** Вверху страницы, под заголовком "WiFi Setup"

**Структура:**
- Горизонтальный контейнер с иконкой слева и текстом справа
- Высота: ~80-100px
- Фон: #F2F2F7 (светло-серый, как в iOS)
- Закругление углов: 12px
- Внутренние отступы: 16px

**Элементы:**

1. **Иконка устройства (слева):**
   - Размер: 48×48 или 56×56px
   - SVG изображение
   - По умолчанию: схематический образ умного устройства для дома
   - Референс: `docs/web-ui/icon_smart_device.svg`
   - Цвет: #007AFF (синий iOS) или градиент
   - Передаётся пользователем через конфигурацию

2. **Название устройства (справа, сверху):**
   - Шрифт: 20px, Bold (700)
   - Цвет: #1C1C1E
   - Пример: "ESP Device v1.x.x"

3. **Описание устройства (справа, под названием):**
   - Шрифт: 15px, Regular (400)
   - Цвет: #8E8E93
   - Пример: "Устройство для умного дома на базе ESP8266/ESP32"
   - Передаётся пользователем через конфигурацию

**Конфигурация (JavaScript):**
```javascript
window.deviceConfig = {
    version: 'ESP Device v1.0.0',           // Название устройства
    description: 'Устройство для умного дома на базе ESP8266/ESP32',  // Описание
    iconSvg: '<svg>...</svg>'               // SVG иконка (опционально)
};
```

**Если иконка не передана:**
- Отображать иконку по умолчанию (схематический умный дом)
- SVG код генерируется автоматически

**Адаптивность:**
- На мобильных: иконка 40×40px, шрифты уменьшаются на 10%
- Контейнер остаётся горизонтальным

---

## Функциональные требования

### 1. Режимы работы

#### 1.1 Режим по умолчанию (AP Mode)
- При первом запуске или после сброса настроек устройство создаёт точку доступа
- **SSID:** `ESP_Device_AP`
- **Пароль:** `password123`
- **IP адрес:** `192.168.4.1`
- Веб-сервер доступен по адресу `http://192.168.4.1`
- **Редактирование:** пользователь может изменить SSID и пароль точки доступа до сохранения настроек

#### 1.2 Сброс к заводским настройкам
- Специальная кнопка (GPIO) удерживается при загрузке устройства (3-5 секунд)
- После сброса:
  - WiFi настройки очищаются
  - Устройство запускается в режиме точки доступа (п. 1.1)
  - Страница настройки WiFi доступна сразу после загрузки

#### 1.3 Рабочий режим (STA Mode)
- После успешной настройки устройство подключается к выбранной пользователем WiFi сети
- Веб-сервер доступен по:
  - mDNS: `http://espdevice.local`
  - IP адресу, выданному роутером

### 2. Страница настройки WiFi

#### 2.1 Основной функционал

1. **Сканирование доступных сетей**
   - Отображение списка обнаруженных WiFi сетей
   - Показывать: SSID, уровень сигнала (RSSI), тип защиты (WPA/WPA2/Open)
   - Сортировка по уровню сигнала (убывание)

2. **Выбор сети**
   - Клик по SSID для выбора
   - Автоматическое заполнение поля SSID
   - Индикация выбранной сети

3. **Ввод пароля**
   - Поле ввода пароля с возможностью показать/скрыть
   - Валидация: минимальная длина 8 символов
   - Для открытых сетей поле пароля скрыто

4. **Подключение**
   - Кнопка "Connect" / "Подключиться"
   - Индикация процесса подключения (анимация/прогресс)
   - Проверка успешности подключения
   - При ошибке — возврат к выбору сети

5. **Настройка точки доступа (AP Mode)**
   - Поля для редактирования SSID и пароля точки доступа
   - Валидация: SSID мин. 1 символ, пароль мин. 8 символов
   - Кнопка "Apply AP Settings" / "Применить настройки AP"

6. **Сохранение и перезагрузка**
   - Кнопка "Save & Reboot" / "Запомнить и перезапустить" (внизу страницы)
   - Сохранение настроек в энергонезависимой памяти (SPIFFS/LittleFS/EEPROM)
   - Перезагрузка устройства после сохранения
   - Редирект на страницу статуса через 10 секунд

#### 2.2 Сброс настроек

- Кнопка "Factory Reset" / "Сброс настроек" в нижней части страницы
- Подтверждение сброса (modal dialog)
- После сброса:
  - Очистка сохранённых WiFi настроек
  - Перезагрузка в режиме точки доступа
  - Возврат на эту же страницу настройки

#### 2.3 Статус подключения

- Индикация текущего статуса:
  - 🔴 Disconnected — не подключено
  - 🟡 Connecting... — подключение
  - 🟢 Connected — подключено, показывать SSID и IP
- Кнопка "Refresh" / "Обновить" для повторного сканирования

### 3. Требования к дизайну

#### 3.1 Общие требования

- **Стиль:** строгий минимализм, в стиле iPhone (iOS Human Interface Guidelines)
- **Фон:** белый (#FFFFFF)
- **Цветовая схема:**
  - Основной текст: #1C1C1E (почти чёрный)
  - Вторичный текст: #8E8E93 (серый)
  - Акцентный цвет: #007AFF (синий iOS)
  - Успех: #34C759 (зелёный)
  - Ошибка: #FF3B30 (красный)
  - Границы: #C6C6C8 (светло-серый)

#### 3.2 Типографика

- **Шрифт:** системный (SF Pro Display для iOS, Roboto для Android, Segoe UI для Windows)
- **Заголовок:** 24px, Bold
- **Подзаголовок:** 17px, Regular
- **Основной текст:** 17px, Regular
- **Вторичный текст:** 15px, Regular
- **Кнопки:** 17px, Semibold

#### 3.3 Макет

- **Ориентация:** вертикальная (mobile-first)
- **Ширина:** адаптивная, 100% ширины экрана
- **Отступы:** 16px по краям, 20px между секциями
- **Высота:** прокручиваемая, контент центрирован

#### 3.4 Компоненты

1. **Header (верхняя панель)**
   - Заголовок: "WiFi Setup" / "Настройка WiFi"
   - Переключатель языка: EN / RU (справа)

2. **Список сетей**
   - Карточки с закруглёнными углами (border-radius: 10px)
   - Тень: 0 2px 8px rgba(0,0,0,0.08)
   - Иконка сигнала (Unicode: 📶) с индикатором уровня
   - Иконка замка для защищённых сетей (Unicode: 🔒 / 🔓)

3. **Поля ввода**
   - Стиль iOS: с закруглёнными углами
   - Высота: 44px (стандарт iOS)
   - Border: 1px solid #C6C6C8
   - Focus: border-color #007AFF

4. **Кнопки**
   - Основная (Save & Reboot): синяя (#007AFF), белый текст
   - Вторичная (Refresh): прозрачная с синей рамкой
   - Опасная (Factory Reset): красная (#FF3B30), белый текст
   - Высота: 44px, border-radius: 10px

5. **Индикаторы**
   - Прогресс подключения: анимированный spinner или progress bar
   - Статус: цветные точки (🔴🟡🟢) + текст

#### 3.5 Unicode иконки

| Элемент | Unicode | Описание |
|---|---|---|
| WiFi сигнал | 📶 | U+1F4F6 |
| Замок (закрыто) | 🔒 | U+1F512 |
| Замок (открыто) | 🔓 | U+1F513 |
| Обновить | 🔄 | U+1F504 |
| Успех | ✅ | U+2705 |
| Ошибка | ❌ | U+274C |
| Предупреждение | ⚠️ | U+26A0 |
| Настройки | ⚙️ | U+2699 |
| Перезагрузка | 🔄 | U+1F504 |

### 4. Языковая локализация

#### 4.1 Структура

- Два языка: **English** (по умолчанию) и **Русский**
- Переключатель в header (справа): EN / RU
- Все тексты интерфейса переводятся
- Сохранение выбора языка в localStorage браузера

#### 4.2 Словарь

| Ключ | English | Русский |
|---|---|---|
| title | WiFi Setup | Настройка WiFi |
| version_label | ESP Device | ESP Device |
| scan_btn | Scan Networks | Сканировать сети |
| refresh_btn | Refresh | Обновить |
| select_network | Select Network | Выберите сеть |
| password_label | Password | Пароль |
| password_placeholder | Enter password | Введите пароль |
| show_password | Show | Показать |
| hide_password | Hide | Скрыть |
| connect_btn | Connect | Подключиться |
| ap_settings_title | Access Point Settings | Настройки точки доступа |
| ap_ssid_label | AP SSID | SSID точки доступа |
| ap_password_label | AP Password | Пароль точки доступа |
| apply_ap_settings_btn | Apply AP Settings | Применить настройки AP |
| save_reboot_btn | Save & Reboot | Запомнить и перезапустить |
| factory_reset_btn | Factory Reset | Сброс настроек |
| status_disconnected | Disconnected | Не подключено |
| status_connecting | Connecting... | Подключение... |
| status_connected | Connected | Подключено |
| confirm_reset | Are you sure you want to reset to factory settings? | Вы уверены, что хотите сбросить настройки к заводским? |
| cancel | Cancel | Отмена |
| confirm | Confirm | Подтвердить |
| success_saved | Settings saved! Rebooting... | Настройки сохранены! Перезагрузка... |
| error_connection | Connection failed. Check password. | Ошибка подключения. Проверьте пароль. |
| no_networks | No networks found | Сети не найдены |
| signal_excellent | Excellent | Отличный |
| signal_good | Good | Хороший |
| signal_weak | Weak | Слабый |
| signal_very_weak | Very Weak | Очень слабый |

### 5. Технические требования

#### 5.1 Фронтенд

- **HTML5** с семантической разметкой
- **CSS3** с Flexbox/Grid для макета
- **Vanilla JavaScript** (без фреймворков для минимизации размера)
- **Fetch API** для AJAX запросов
- **localStorage** для сохранения выбора языка
- **Single Page Application** подход (без перезагрузки страниц)

#### 5.2 Бэкенд (ESP8266/ESP32)

- **HTTP сервер:** ESP8266WebServer / WebServer
- **API endpoints:**
  - `GET /` — страница настройки
  - `GET /api/scan` — сканирование сетей (JSON)
  - `POST /api/connect` — подключение к сети (JSON)
  - `GET /api/status` — статус подключения (JSON)
  - `POST /api/save` — сохранение настроек (JSON)
  - `POST /api/reset` — сброс настроек (JSON)
  - `POST /api/ap_settings` — настройка точки доступа (JSON)
- **Хранение данных:**
  - SPIFFS/LittleFS для HTML/CSS/JS файлов
  - EEPROM или Preferences для WiFi настроек
- **mDNS:** для доступа по имени в рабочем режиме

#### 5.2.1 Структура конфигурации (для библиотеки ETL)

**Файл:** `src/etl_wifi_setup.h`

```cpp
namespace etl::wifi {
    struct server_config_t {
        String hostname = "espdevice";              // Имя хоста для mDNS
        String ap_ssid = "ESP_Device_AP";           // SSID точки доступа по умолчанию
        String ap_password = "password123";         // Пароль точки доступа по умолчанию
        String sta_ssid = "";                       // SSID внешней сети (пусто = не подключено)
        String sta_password = "";                   // Пароль внешней сети
        uint16_t port = 80;                         // Порт веб-сервера
        uint32_t update_interval = 500;             // Интервал обновления данных (мс)
    };

    struct scan_result_t {
        String ssid;                                // SSID сети
        int32_t rssi;                               // Уровень сигнала (dBm)
        String encryption;                          // Тип шифрования (WPA2, WPA, Open)
        uint8_t channel;                            // Канал
    };

    enum class connection_status_t {
        disconnected,                               // Не подключено
        connecting,                                 // Подключение
        connected,                                  // Подключено
        error                                       // Ошибка
    };

    class wifi_setup {
    public:
        explicit wifi_setup(const server_config_t& cfg = server_config_t());
        virtual ~wifi_setup();

        virtual bool begin();                       // Инициализация WiFi сервера
        virtual void stop();                        // Остановка и освобождение ресурсов
        virtual void handle();                      // Основной цикл обработки

        virtual bool is_initialized() const;        // Проверка инициализации
        virtual connection_status_t get_connection_status() const;
        virtual bool is_connected() const;

        virtual String get_ip_address() const;
        virtual String get_mode() const;

        virtual int32_t scan_networks(std::vector<scan_result_t>& results);
        virtual bool connect_to_network(const String& ssid, const String& password, uint32_t timeout = 10000);
        virtual void disconnect();

        virtual bool save_settings();               // Сохранение настроек в LittleFS
        virtual bool load_settings();               // Загрузка настроек из LittleFS
        virtual bool reset_settings();              // Сброс настроек к заводским

        virtual void set_config(const server_config_t& cfg);
        virtual const server_config_t& get_config() const;

        virtual void reboot();                      // Перезагрузка устройства

    protected:
        // Защищённые методы для наследования
        virtual bool start_ap();
        virtual bool connect_to_sta(uint32_t timeout);
        virtual void update_connection_status();
        virtual String get_encryption_type(uint8_t type) const;
    };
}
```

**Методы:**

| Метод | Описание |
|---|---|
| `begin()` | Инициализация: загрузка настроек, попытка подключения к STA, запуск AP |
| `stop()` | Остановка: отключение от WiFi, остановка AP, сброс флага инициализации |
| `handle()` | Вызывать в loop() для обновления статуса подключения |
| `scan_networks()` | Сканирование сетей, возврат отсортированного списка по RSSI |
| `connect_to_network()` | Подключение к сети с сохранением настроек |
| `save_settings()` | Сохранение настроек в LittleFS (/wifi_settings.conf) |
| `load_settings()` | Загрузка настроек из LittleFS |
| `reset_settings()` | Удаление файла настроек, сброс к значениям по умолчанию |
| `reboot()` | Перезагрузка устройства через ESP.reset() |

**Примечание для проекта Moonshine:**
- В проекте `Moonshine` структура конфигурации будет переопределена через `moonshine_server_config_t`
- Имя хоста: `"moonshine"`
- AP SSID: `"Moonshine_AP"`
- AP Password: `"moonshine123"`
- Веб-сервер запускается вручную через `moonshine_web_server::begin()`

#### 5.2.3 Стиль кодированя

для имен классов, структур и методов использовать snake_style - все буквы строчные с разделителм "_"

#### 5.3 Форматы данных

**GET /api/scan — ответ:**
```json
{
  "networks": [
    {
      "ssid": "MyHomeWiFi",
      "rssi": -65,
      "encryption": "WPA2",
      "channel": 6
    },
    {
      "ssid": "OpenNetwork",
      "rssi": -80,
      "encryption": "none",
      "channel": 11
    }
  ]
}
```

**POST /api/connect — запрос:**
```json
{
  "ssid": "MyHomeWiFi",
  "password": "secret123"
}
```

**POST /api/connect — ответ:**
```json
{
  "success": true,
  "message": "Connected",
  "ip": "192.168.1.42"
}
```

**GET /api/status — ответ:**
```json
{
  "connected": true,
  "ssid": "MyHomeWiFi",
  "ip": "192.168.1.42",
  "rssi": -65
}
```

**POST /api/save — запрос:**
```json
{
  "ssid": "MyHomeWiFi",
  "password": "secret123"
}
```

**POST /api/reset — ответ:**
```json
{
  "success": true,
  "message": "Settings reset. Rebooting..."
}
```

**POST /api/ap_settings — запрос:**
```json
{
  "ap_ssid": "MyDevice_AP",
  "ap_password": "newpassword123"
}
```

**POST /api/ap_settings — ответ:**
```json
{
  "success": true,
  "message": "AP settings applied. Reconnecting...",
  "ap_ssid": "MyDevice_AP"
}
```

### 6. Сценарии использования

#### 6.1 Первичная настройка

1. Пользователь включает устройство
2. Устройство создаёт точку доступа `ESP_Device_AP`
3. Пользователь подключается к `ESP_Device_AP` с паролем `password123`
4. Открывает `http://192.168.4.1`
5. Видит список доступных сетей
6. Выбирает свою сеть, вводит пароль
7. Нажимает "Connect"
8. При успехе — "Save & Reboot"
9. Устройство перезагружается, подключается к домашней сети
10. Пользователь подключается к `http://espdevice.local`

#### 6.2 Сброс настроек

1. Пользователь зажимает кнопку при загрузке (3-5 сек)
2. Устройство загружается в режиме настройки
3. Все WiFi настройки сброшены
4. Пользователь настраивает заново (см. п. 6.1)

#### 6.3 Настройка точки доступа (AP Mode)

1. Пользователь открывает страницу настройки в режиме AP
2. Изменяет SSID точки доступа (например, на "MyDevice_AP")
3. Изменяет пароль (мин. 8 символов)
4. Нажимает "Apply AP Settings"
5. Точка доступа перезапускается с новыми настройками
6. Пользователь переподключается к новой сети

#### 6.4 Ошибка подключения

1. Пользователь вводит неверный пароль
2. Нажимает "Connect"
3. Получает ошибку "Connection failed"
4. Исправляет пароль
5. Повторяет попытку

---

## Декомпозиция задач

### Этап 1: Базовая структура проекта

**Задача:** Создать каркас проекта с минимальным функционалом

**Подзадачи:**
- [ ] 1.1 Создать структуру файлов:
  - `src/etl_wifi_setup.h` — объявление класса etl::wifi::server_setup
  - `src/etl_wifi_setup.cpp` — реализация сервера
  - `docs/web-ui/etl_wifi_setup.xxx.html` — HTML шаблон страницы настройки
- [ ] 1.2 Настроить HTTP сервер на ESP8266
- [ ] 1.3 Реализовать базовый роутинг (/, /api/*)
- [ ] 1.4 Настроить режим точки доступа (AP)
- [ ] 1.5 Добавить логирование в Serial

**Результат:** Устройство создаёт точку доступа, страница доступна по 192.168.4.1

---

### Этап 2: HTML/CSS макет

**Задача:** Разработать визуальный интерфейс страницы настройки

**Подзадачи:**
- [ ] 2.1 Создать HTML структуру (header, main, footer)
- [ ] 2.2 Реализовать CSS стили в iOS-стиле
- [ ] 2.3 Создать компонент списка WiFi сетей
- [ ] 2.4 Создать форму ввода SSID и пароля
- [ ] 2.5 Добавить кнопки (Save & Reboot, Factory Reset)
- [ ] 2.6 Реализовать адаптивную вёрстку (mobile-first)
- [ ] 2.7 Добавить Unicode иконки

**Результат:** Статичная страница с полным дизайном

**Итерации:** Макет странцы в формате html
На каждой итерации результат помещать в новый файл `docs/web-ui/etl_wifi_setup.xxx.html`, увеличивать номер и не трогать предыдущий варинат.

---

### Этап 3: JavaScript интерактивность

**Задача:** Добавить клиентскую логику

**Подзадачи:**
- [ ] 3.1 Реализовать систему локализации (i18n)
- [ ] 3.2 Переключатель языков 🇬🇧/🇷🇺
- [ ] 3.3 AJAX запрос к /api/scan для получения списка сетей
- [ ] 3.4 Отображение списка сетей с индикатором сигнала
- [ ] 3.5 Выбор сети (клик по SSID)
- [ ] 3.6 Валидация пароля (мин. 8 символов)
- [ ] 3.7 Показать/скрыть пароль
- [ ] 3.8 Индикация статуса подключения
- [ ] 3.9 Обработка ошибок подключения
- [ ] 3.10 Сохранение в localStorage выбора языка

**Результат:** Полностью интерактивная страница без бэкенда

---

### Этап 4: Бэкенд API

**Задача:** Реализовать серверную часть для работы с WiFi

**Подзадачи:**
- [ ] 4.1 API `/api/scan` — сканирование сетей
  - WiFi.scanNetworks()
  - Форматирование результата в JSON
  - Кэширование результатов (30 сек)
- [ ] 4.2 API `/api/connect` — подключение к сети
  - WiFi.begin(ssid, password)
  - Ожидание подключения (таймаут 10 сек)
  - Проверка статуса (WL_CONNECTED)
  - Возврат IP адреса
- [ ] 4.3 API `/api/status` — статус подключения
  - Проверка WiFi.status()
  - Возврат SSID, IP, RSSI
- [ ] 4.4 API `/api/save` — сохранение настроек
  - Запись в EEPROM/LittleFS
  - Структура: SSID + password (опционально encrypted)
- [ ] 4.5 API `/api/reset` — сброс настроек
  - Очистка EEPROM/LittleFS
  - Флаг сброса для перезагрузки

**Результат:** Рабочее API для управления WiFi

---

### Этап 5: Интеграция и тестирование

**Задача:** Соединить фронтенд и бэкенд, протестировать

**Подзадачи:**
- [ ] 5.1 Интеграция AJAX запросов с API
- [ ] 5.2 Обработка ошибок сети (таймауты, 503)
- [ ] 5.3 Индикация процесса подключения (spinner/progress)
- [ ] 5.4 Авто-редирект после сохранения настроек
- [ ] 5.5 Страница "Rebooting..." с таймером
- [ ] 5.6 Тестирование на реальных устройствах (ESP8266)
- [ ] 5.7 Тестирование на разных браузерах (iOS Safari, Android Chrome)
- [ ] 5.8 Оптимизация размера HTML/CSS/JS (minification)

**Результат:** Полностью рабочая система настройки WiFi

---

### Этап 6: Дополнительные улучшения (опционально)

**Подзадачи:**
- [ ] 6.1 WPS подключение (если поддерживается)
- [ ] 6.2 Сохранение истории сетей (последние 5)
- [ ] 6.3 Авто-подключение при загрузке
- [ ] 6.4 Fallback режим (если подключение не удалось через 30 сек)
- [ ] 6.5 HTTPS поддержка (SSL сертификат)
- [ ] 6.6 Captive Portal для авто-открытия страницы
- [ ] 6.7 OTA обновление через веб-интерфейс

---

## План работы с ИИ

### Для Qwen 30B/7B (LM Studio)

**Рекомендуемый порядок выполнения:**

1. **Этап 1** — попросить ИИ создать базовую структуру проекта
   - Промт: "Создай класс etl::wifi::server_setup для ESP8266 с HTTP сервером на порту 80 и точкой доступа..."

2. **Этап 2** — запросить HTML/CSS макет
   - Промт: "Создай HTML страницу в стиле iOS для настройки WiFi с белым фоном, закруглёнными кнопками..."

3. **Этап 3** — добавить JavaScript
   - Промт: "Добавь JavaScript для AJAX запросов к API, систему локализации en/ru..."

4. **Этап 4** — реализовать бэкенд API
   - Промт: "Реализуй API endpoints для сканирования WiFi, подключения, сохранения настроек..."

5. **Этап 5** — интеграция и отладка
   - Промт: "Интегрируй фронтенд с бэкендом, добавь обработку ошибок..."

### Примеры промтов для каждого этапа

**Этап 1:**
```
Создай файл src/etl_wifi_setup.h и src/etl_wifi_setup.cpp для ESP8266.
Класс etl::wifi::server_setup должен:
- Создавать точку доступа "ESP_Device_AP" с паролем "password123"
- Запускать HTTP сервер на порту 80
- Иметь метод begin() и handleClient()
- Логировать действия в Serial
- Поддерживать конфигурацию: hostname, ap_ssid, ap_password через структуру
```

**Этап 2:**
```
Создай HTML страницу docs/web-ui/etl_wifi_setup.html в стиле iOS:
- Белый фон, шрифт SF Pro
- Заголовок "WiFi Setup" с переключателем языков EN/RU
- Список WiFi сетей в виде карточек с иконками 📶🔒
- Форма ввода пароля для выбранной сети
- Секция настройки точки доступа (SSID и пароль AP)
- Кнопки "Save & Reboot" (синяя) и "Factory Reset" (красная)
- Mobile-first вёрстка для мобильных телефонов
- Версия устройства в заголовке (ESP Device v1.0.0)
```

**Этап 3:**
```
Добавь JavaScript к HTML странице:
- Объект с переводами en/ru
- Функция переключения языка EN/RU
- Fetch API для GET /api/scan
- Отображение списка сетей с сортировкой по RSSI
- Валидация пароля (мин. 8 символов)
- Показать/скрыть пароль
- Обработка настройки точки доступа
```

---

## Критерии приёмки

- [ ] Устройство создаёт точку доступа `ESP_Device_AP`
- [ ] Страница доступна по `http://192.168.4.1`
- [ ] Список сетей сканируется и отображается
- [ ] Подключение к WiFi работает
- [ ] Настройки сохраняются после перезагрузки
- [ ] Сброс настроек работает
- [ ] Переключение языков EN/RU работает
- [ ] Настройка точки доступа (SSID/пароль AP) работает
- [ ] Дизайн соответствует iOS стилю
- [ ] Страница корректно отображается на мобильных устройствах
- [ ] Версия устройства отображается в заголовке

---

## Приложения

### A. Референсы дизайна

- [iOS Human Interface Guidelines](https://developer.apple.com/design/human-interface-guidelines/)
- [Apple Design Resources](https://developer.apple.com/design/resources/)

### B. Полезные ссылки

- [ESP8266 WiFi Library](https://arduino-esp8266.readthedocs.io/en/latest/esp8266wifi/readme.html)
- [ESP8266WebServer Library](https://github.com/esp8266/Arduino/tree/master/libraries/ESP8266WebServer)
- [LittleFS for ESP8266](https://github.com/esp8266/LittleFS)

### C. Инструменты

- **LM Studio** — запуск Qwen 30B/7B локально
- **PlatformIO** — сборка и прошивка
- **Chrome DevTools** — отладка веб-интерфейса

---

*Документ создан: 2026-02-25*
*Версия: 1.0*

---

## История разработки WiFi Setup UI

### Итерации макетов

#### v001 ✅ — Базовый макет
**Файл:** `qwen-wifi_setup.001.html`
**Дата:** 2026-02-25

**Реализованный функционал:**
- ✅ Header с переключателем языков EN/RU
- ✅ Версия устройства в заголовке (ESP Device v1.0.0)
- ✅ Индикатор статуса подключения (🔴🟡🟢)
- ✅ Список WiFi сетей с иконками сигнала и замка
- ✅ Форма ввода пароля с кнопкой показать/скрыть
- ✅ Кнопка Connect для подключения к сети
- ✅ Секция настройки точки доступа (AP SSID и пароль)
- ✅ Кнопки Save & Reboot и Factory Reset
- ✅ Modal dialog для подтверждения сброса
- ✅ Система локализации (EN/RU) с сохранением в localStorage
- ✅ Сортировка сетей по уровню сигнала (RSSI)
- ✅ Валидация пароля (мин. 8 символов)
- ✅ Анимация spinner для загрузки
- ✅ iOS-стиль дизайна (белый фон, закруглённые кнопки, синие акценты)

**Технические детали:**
- HTML5 + CSS3 + Vanilla JavaScript
- Fetch API для AJAX запросов
- Адаптивная вёрстка (mobile-first)
- Все тексты в словаре translations
- Состояние хранится в переменных (selectedNetwork, networks, currentLang)

**API endpoints (ожидаемые):**
- `GET /api/scan` — сканирование сетей
- `POST /api/connect` — подключение к сети
- `POST /api/save` — сохранение настроек
- `POST /api/reset` — сброс настроек
- `POST /api/ap_settings` — настройка точки доступа

**Известные ограничения:**
- Нет бэкенда (только фронтенд)
- Статус подключения не обновляется автоматически
- Нет обработки ошибок сети (таймауты, 503)

#### v002 ✅ — Симуляция API и подзаголовок устройства
**Файл:** `qwen-wifi_setup.002.html`
**Дата:** 2026-02-25

**Новый функционал:**
- ✅ Симуляция API для демонстрации (SIMULATION_MODE = true)
- ✅ Генерация 3 сетей FIREFLY* с разным уровнем сигнала (±5 dBm)
- ✅ Пароль для всех сетей: 12345678
- ✅ Подзаголовок устройства в header (тонкий шрифт 13px)
- ✅ Конфигурация deviceConfig для кастомизации (version, subtitle)
- ✅ Симуляция задержек API (800ms scan, 1500ms connect, 1000ms save)
- ✅ Экран перезагрузки после Save & Reboot
- ✅ Экран сброса после Factory Reset

**Изменения в дизайне:**
- ✅ Заголовок "WiFi Setup" уменьшен до 17px (как "Access Point Settings")
- ✅ Подзаголовок устройства: 13px, цвет #8E8E93, тонкий шрифт
- ✅ Версия перемещена из отдельного блока в header
- ✅ Динамическое отображение подзаголовка (скрыт если "ESP Device v1.0.0")

**Технические детали:**
- `window.deviceConfig` для конфигурации устройства
- `generateSimulatedNetworks()` генерирует FIREFLY_HOME, FIREFLY_GUEST, FIREFLY_IOT
- RSSI: -45, -55, -65 dBm ±5 dBm случайная вариация
- Все API вызовы обернуты в проверку SIMULATION_MODE
- Для production установить `SIMULATION_MODE = false`

**Пример конфигурации для Moonshine:**
```javascript
window.deviceConfig = {
    version: 'ESP Device v1.0.0',
    subtitle: 'Moonshine v1.2.3'  // или 'Distillation Control System'
};
```

**Известные ограничения:**
- Симуляция не требует реального бэкенда
- Для работы с устройством нужен реальный API

#### v003 ✅ — Улучшение UX и описание устройства
**Файл:** `qwen-wifi_setup.003.html`
**Дата:** 2026-02-25

**Новый функционал:**
- ✅ Контейнер "Selected Network" появляется только при выборе сети из списка
- ✅ Секция с паролем скрывается при переключении фокуса на AP Settings или другие кнопки
- ✅ Зелёная галочка (✅) рядом с замком при успешном подключении к сети
- ✅ Поле description в deviceConfig для дополнительного описания устройства

**Изменения в дизайне:**
- ✅ header-subtitle: увеличен до 15px, bold (600), цвет #1C1C1E
- ✅ header-description: новый элемент, 13px, тонкий (400), цвет #8E8E93
- ✅ password-section: скрыт по умолчанию (hidden), показывается при выборе сети
- ✅ network-lock: добавлена галочка ✅ для подключённой сети

**Технические детали:**
- `passwordSection.classList.remove('hidden')` при выборе сети
- Обработчик клика на document для скрытия passwordSection
- `networks[networkIndex].connected = true` после успешного подключения
- Перерисовка списка сетей после подключения

**Пример конфигурации для Moonshine:**
```javascript
window.deviceConfig = {
    version: 'ESP Device v1.0.0',
    subtitle: 'Moonshine v1.2.3',
    description: 'Temperature and water flow control'  // или 'Система контроля дистилляции'
};
```

**Известные ограничения:**
- Симуляция не требует реального бэкенда
- Для работы с устройством нужен реальный API

#### v004 ✅ — Редизайн Selected Network и Disconnect
**Файл:** `qwen-wifi_setup.004.html`
**Дата:** 2026-02-25

**Новый функционал:**
- ✅ Заголовок выбранной сети без поля редактирования (только текст)
- ✅ Горизонтальный разделитель под заголовком сети
- ✅ Кнопка "Connect" переименована в "Join"
- ✅ Кнопка "Disconnect" при подключённой сети (вместо пароля)
- ✅ Автоматическое скрытие поля пароля при подключении
- ✅ Возврат поля пароля после отключения
- ✅ Unicode иконки глаз (👁️/👁️‍🗨️) вместо текста Show/Hide
- ✅ Сброс состояния подключения при выборе новой сети

**Изменения в дизайне:**
- ✅ selected-network-title: 17px, bold (600), цвет #1C1C1E
- ✅ selected-network-divider: горизонтальная линия 1px, цвет #C6C6C8
- ✅ passwordInputGroup: скрывается при подключении
- ✅ Кнопка Join: синяя (btn-primary)
- ✅ Кнопка Disconnect: прозрачная с синей рамкой (btn-secondary)
- ✅ Кнопка show/hide password: Unicode глаза (👁️ закрыт, 👁️‍🗨️ открыт)

**Технические детали:**
- `selectNetwork()`: проверка `networks[index].connected` для режима Disconnect
- При выборе новой сети: сброс `connected = false` у предыдущей
- Обработчик connectBtn: проверка `isConnected` для Disconnect
- passwordInputGroup.classList.add/remove('hidden') для показа/скрытия
- showPasswordBtn.textContent: '👁️' или '👁️‍🗨️' в зависимости от типа поля

**Пример конфигурации для Moonshine:**
```javascript
window.deviceConfig = {
    version: 'ESP Device v1.0.0',
    subtitle: 'Moonshine v1.2.3',
    description: 'Temperature and water flow control'
};
```

**Известные ограничения:**
- Симуляция не требует реального бэкенда
- Для работы с устройством нужен реальный API

#### v005 ✅ — Возврат текста Show/Hide и увеличение шрифтов header
**Файл:** `qwen-wifi_setup.005.html`
**Дата:** 2026-02-25

**Изменения:**
- ✅ Возврат текста "Show/Hide" вместо Unicode иконок глаз
- ✅ header-subtitle: увеличен до 17px (было 15px)
- ✅ header-description: увеличен до 14px (было 13px), отступ сверху 4px (было 2px)
- ✅ show-password-btn: шрифт 13px, weight 500 (как было изначально)

**Технические детали:**
- showPasswordBtn.textContent: использует translations[currentLang].show_password/hide_password
- Динамическая смена текста при переключении типа поля

**Пример конфигурации для Moonshine:**
```javascript
window.deviceConfig = {
    version: 'ESP Device v1.0.0',
    subtitle: 'Moonshine v1.2.3',
    description: 'Temperature and water flow control'
};
```

**Известные ограничения:**
- Симуляция не требует реального бэкенда
- Для работы с устройством нужен реальный API

#### v006 ✅ — Контейнер информации об устройстве
**Файл:** `qwen-wifi_setup.006.html`
**Дата:** 2026-02-26

**Новый функционал:**
- ✅ Контейнер информации об устройстве (device-info-container) под заголовком
- ✅ Горизонтальный макет: иконка слева, текст справа
- ✅ Иконка устройства по умолчанию (SVG, схематический умный дом)
- ✅ Название устройства (device-name): 20px, Bold, #1C1C1E
- ✅ Описание устройства (device-description): 15px, Regular, #8E8E93
- ✅ Поддержка кастомной иконки через deviceConfig.iconSvg
- ✅ Значения по умолчанию:
  - version: "ESP Device v1.0.0"
  - description: "Устройство для умного дома на базе ESP8266/ESP32"

**Изменения в дизайне:**
- ✅ device-info-container: фон #F2F2F7, border-radius 12px, padding 16px
- ✅ device-icon: 48×48px, SVG
- ✅ Адаптивность для мобильных: иконка 40×40px, шрифты уменьшаются
- ✅ Удалён отдельный блок version-label (перемещён в device-info-container)

**Технические детали:**
- DEFAULT_DEVICE_ICON: SVG код иконки по умолчанию (умный дом)
- applyDeviceConfig(): применяет конфигурацию из window.deviceConfig
- Конфигурация:
  ```javascript
  window.deviceConfig = {
      version: 'ESP Device v1.0.0',
      description: 'Описание устройства',
      iconSvg: '<svg>...</svg>'  // опционально
  };
  ```

**Пример конфигурации для Moonshine:**
```javascript
window.deviceConfig = {
    version: 'Moonshine v1.2.6',
    description: 'Система контроля температуры и потока воды',
    iconSvg: null  // Использовать иконку по умолчанию
};
```

**Известные ограничения:**
- Симуляция не требует реального бэкенда
- Для работы с устройством нужен реальный API

#### v007 ✅ (АКТУАЛЬНАЯ) — Исправление отображения WiFi сетей и иконки
**Файл:** `qwen-wifi_setup.007.html`
**Дата:** 2026-02-26

**Исправления:**
- ✅ Убраны децибелы из отображения уровня сигнала
- ✅ Возвращена информация о типе шифрования (WPA2, Open)
- ✅ Формат отображения: "Хороший • WPA2" (вместо "Слабый • -65 dBm")
- ✅ Зелёная галочка ✅ перемещена к замку (после типа шифрования)
- ✅ Иконка устройства заменена на SVG из icon_smart_device.svg
- ✅ Увеличена версия: v1.0.0 → v1.0.7

**Изменения в дизайне:**
- ✅ network-signal: отображает уровень сигнала + тип шифрования
- ✅ checkmark: перемещён из network-name в network-signal (после encryption)
- ✅ network-lock: добавлен margin-left: 8px для разделения
- ✅ device-icon: новый SVG (дом с крышей и круглым элементом)

**Технические детали:**
- renderNetworks(): изменён формат строки сигнала
- checkmark теперь отображается после encryption: `${network.encryption}${checkmark}`
- DEFAULT_DEVICE_ICON: обновлён SVG из файла icon_smart_device.svg

**Пример конфигурации для Moonshine:**
```javascript
window.deviceConfig = {
    version: 'Moonshine v1.2.6',
    description: 'Система контроля температуры и потока воды',
    iconSvg: null  // Использовать иконку из icon_smart_device.svg
};
```

**Известные ограничения:**
- Симуляция не требует реального бэкенда
- Для работы с устройством нужен реальный API

---

## Правила работы над проектом (для ИИ)

### Версионирование файлов

1. **Макеты HTML**
   - Формат имени: `qwen-wifi_setup.XXX.html`
   - XXX — трёхзначный номер версии (001, 002, 003...)
   - Каждая итерация создаёт НОВЫЙ файл с увеличенным номером
   - Исходные файлы не удаляются и не изменяются
   - Актуальная версия отмечается в истории как "АКТУАЛЬНАЯ"

2. **История изменений**
   - Все изменения записываются в этот документ (`task_wifi_setup_design.md`)
   - В разделе "История разработки WiFi Setup UI"
   - Каждая итерация включает:
     - Номер версии (vXXX)
     - Название (краткое описание)
     - Список реализованного функционала (чек-лист)
     - Технические детали
     - Известные ограничения

### Порядок работы

1. **Перед началом работы**
   - Прочитать этот документ полностью
   - Проверить последнюю версию макета в истории
   - Убедиться, что все требования понятны

2. **При создании новой версии**
   - Взять за основу предыдущую версию макета
   - Внести запрошенные изменения
   - Сохранить в новый файл с увеличенным номером (001 → 002 → 003...)
   - Обновить историю в этом документе

3. **При обновлении истории**
   - Добавить новую запись в раздел "История разработки WiFi Setup UI"
   - Указать номер версии, дату, реализованный функционал
   - Отметить актуальную версию как "АКТУАЛЬНАЯ"
   - Предыдущую версию пометить как зачёркнутую или оставить без отметки

### Продолжение работы в следующем сеансе

Если работа прерывается и продолжается в следующем сеансе:

1. **Прочитать раздел "История разработки"**
   - Найти последнюю версию с отметкой "АКТУАЛЬНАЯ"
   - Проверить список реализованного функционала
   - Проверить известные ограничения

2. **Определить следующую задачу**
   - Если есть незавершённые подзадачи из декомпозиции — продолжить их
   - Если все подзадачи выполнены — запросить новую задачу у пользователя

3. **Создать новую версию**
   - Увеличить номер версии на 1 (например, 001 → 002)
   - Внести изменения в новый файл
   - Обновить историю

### Пример записи в истории

```markdown
#### v002 ✅ — Название итерации
**Файл:** `qwen-wifi_setup.002.html`
**Дата:** 2026-02-XX

**Реализованный функционал:**
- ✅ Описание изменения 1
- ✅ Описание изменения 2

**Технические детали:**
- Описание технических решений

**Известные ограничения:**
- Что ещё не работает или требует доработки
```

### Контакты и обратная связь

При возникновении вопросов или неясностей:
1. Проверить раздел "Декомпозиция задач" — возможно задача уже описана
2. Проверить раздел "Технические требования" — возможно есть уточнения
3. Если вопрос не освещён в документе — запросить clarification у пользователя

---

## Структура файлов проекта

```
docs/web-ui/
├── qwen-distillation.043.html    # ✅ Distillation monitoring UI (актуальная)
├── qwen-wifi_setup.001.html      # WiFi Setup UI (базовый макет, v1.0.0)
├── qwen-wifi_setup.002.html      # WiFi Setup UI (симуляция API + подзаголовок)
├── qwen-wifi_setup.003.html      # WiFi Setup UI (Улучшение UX + description)
├── qwen-wifi_setup.004.html      # WiFi Setup UI (Редизайн Selected Network + Disconnect)
├── qwen-wifi_setup.005.html      # ✅ WiFi Setup UI (Show/Hide текст + шрифты header, АКТУАЛЬНАЯ)
├── task_wifi_setup_design.md     # Этот документ — ТЗ и история разработки
├── webui_task.md                 # ТЗ для web-ui мониторинга
└── WEB_UI-HISTORY.md             # История distillation monitoring UI
```

---

*Последнее обновление истории: 2026-02-25 (v005)*
*Актуальная версия макета: v005 (qwen-wifi_setup.005.html)*
