JimorMarlow/Moonshine/docs/web-ui/WEB_UI-HISTORY.md

# Moonshine Web UI — История изменений

## О проекте

### Moonshine Distillation Monitoring

Веб-интерфейс мониторинга процесса дистилляции для проекта Moonshine (Arduino).

**Особенности:**
- SVG-схема дистилляционной установки с анимациями
- Отображение датчиков температуры и потока в реальном времени
- Анимация пузырьков в нагревателе (зависит от температуры)
- Анимация капель продукта (зависит от температуры пара)
- Вращающиеся турбины в датчиках потока
- Градиентные трубы для выходной воды (цвет зависит от температуры)
- Система правил с предупреждениями и ошибками
- Симуляция работы для демонстрации

**Последняя версия:** `qwen-distillation.043.html` (встроен в src/web-ui.cpp, v1.2.10)

---

### WiFi Setup UI

Веб-интерфейс для первичной настройки WiFi подключения устройств на базе ESP8266/ESP32.

**Особенности:**
- Сканирование доступных WiFi сетей
- Подключение к выбранной сети с сохранением настроек
- Настройка точки доступа (SSID, пароль)
- Сброс к заводским настройкам
- iOS-стиль дизайна
- Локализация EN/RU
- Контейнер информации об устройстве с иконкой

**Последняя версия:** `qwen-wifi_setup.008.html` (v1.0.8)

---

## Правила

- Файл `WEB_UI-HISTORY.md` можно редактировать самостоятельно без подтверждения для добавления записей об изменениях
- **Все изменения вноси в НОВЫЙ файл с увеличенным номером версии**, обновляй версию в заголовке и добавляй запись в этот файл
- Для каждого проекта свой префикс файлов:
  - `qwen-distillation.XXX.html` — мониторинг дистилляции
  - `qwen-wifi_setup.XXX.html` — настройка WiFi

---

## История итераций — Moonshine Distillation

### v000 — Начальная версия
- Базовая SVG-схема дистилляционной установки
- Компоненты: Heater, Column, Deflegmator, Condenser
- Датчики температуры и потока
- Карточки сенсоров в правой панели

### v005 — v006
- Добавлены стили для компонентов
- Настроена сетка макета

### v007 — v010
- Добавлены градиенты для колонны
- Настроены цвета труб

### v011 — v015
- Добавлена анимация пузырьков в нагревателе
- Добавлена анимация капель продукта
- Настроены скорости анимаций в зависимости от температуры

### v016 — v020
- Добавлены вращающиеся турбины для датчиков потока
- Анимация потока воды с dasharray
- Предупреждающие иконки для отсутствия потока

### v021 — v025
- Добавлена система правил (Rules System)
- StatusBar с предупреждениями и ошибками
- Правила:
  - Heater > 55 AND Cool.Flow = 0 → Warning
  - Cool.T > 30 → Warning/Error
  - DF.T > 30 → Warning/Error

### v026
- Улучшена цветовая схема температур
- Градиент от синего (20°C) через зелёный к красному (30°C+)

### v027
- Финальная версия базового функционала
- Версия: v1.0.21
- Все анимации работают корректно

### v028
- Изменён путь трубы DF.Flow: теперь сначала вправо до середины дефлегматора (x=330), потом вверх
- Версия обновлена: v1.0.21 → v1.0.22

### v029
- Изменён путь трубы Cool.Flow: сначала влево до середины конденсатора (x=420), потом вверх
- Добавлены градиенты для вертикальных частей выходных труб
- Версия обновлена: v1.0.22 → v1.0.23

### v030
- Высота SVG viewBox уменьшена: 600 → 480
- Версия обновлена: v1.0.23 → v1.0.24

### v031
- Ширина SVG viewBox изменена: 700 → 480 (квадратный контейнер)
- Версия обновлена: v1.0.24 → v1.0.25

### v032
- Сдвиг всей схемы на 50 единиц влево (все X-координаты -50)
- Версия обновлена: v1.0.25 → v1.0.26

### v033
- Сдвиг всей схемы ещё на 50 единиц влево (итого -100 от v031)
- Ширина SVG viewBox увеличена: 480 → 530
- Версия обновлена: v1.0.26 → v1.0.27

### v034
- `.scheme-container`: Добавлена высота `height: 100%` и `display: flex; flex-direction: column;`
- `.distillation-svg`: Изменено `height: auto` → `height: 100%`
- `preserveAspectRatio`: Изменено с `xMidYMid meet` на `xMidYMid slice`
- `.sensors-panel`: Добавлены `height: 100%`, `display: flex; flex-direction: column;`, `overflow: hidden;`
- `.sensors-content`: Новый класс-обёртка с `flex: 1` и `overflow-y: auto`
- Заголовок обновлён: `Moonshine v1.0.27` → `Moonshine v1.1.3`
- Версия обновлена: v1.0.27 → v1.1.3

### v035
- `.status-bar`: Изменён шрифт — `font-size: 11px`, `font-weight: 400`
- Все элементы схемы сдвинуты на 5 единиц влево (все X-координаты -5)
- Добавлен `COLOR_BLENDER` — конфигурируемый массив ключевых точек `{ temp, color }`
- Функция `getTempColor()` переписана для работы с `COLOR_BLENDER`
- Заголовок обновлён: `Moonshine v1.1.3` → `Moonshine v1.1.4`
- Версия обновлена: v1.1.3 → v1.1.4

### v036
- **Вертикальный макет** (`@media max-width: 900px`):
  - `.main-panel`: `grid-template-rows: auto auto`, `height: auto`
  - `.scheme-container`: `height: auto`, `min-height: 480px`, `aspect-ratio: 530 / 480`
  - `.sensors-panel`: `max-height: 50vh` — прокрутка внутри
- Заголовок обновлён: `Moonshine v1.1.4` → `Moonshine v1.1.5`
- Версия обновлена: v1.1.4 → v1.1.5

### v037
- **Вертикальный макет** (`@media max-width: 900px`):
  - `.sensors-panel`: `max-height: none`, `overflow: visible`
  - `.sensors-content`: `overflow-y: visible`
  - Страница прокручивается целиком — схема видна полностью, таблица расположена ниже
- Заголовок обновлён: `Moonshine v1.1.5` → `Moonshine v1.1.6`
- Версия обновлена: v1.1.5 → v1.1.6

### v038
- **Горизонтальный макет:**
  - `.main-panel`: Изменено `grid-template-columns: 1fr minmax(250px, 1fr)` → `grid-template-columns: minmax(530px, 1fr) 300px`
  - `.scheme-container`: Добавлено `min-width: 0`
- Заголовок обновлён: `Moonshine v1.1.6` → `Moonshine v1.1.7`
- Версия обновлена: v1.1.6 → v1.1.7

### v039
- **Горизонтальный макет:**
  - SVG: Изменено `preserveAspectRatio="xMidYMid slice"` → `preserveAspectRatio="xMidYMid meet"`
- Заголовок обновлён: `Moonshine v1.1.7` → `Moonshine v1.1.8`
- Версия обновлена: v1.1.7 → v1.1.8

### v040
- **Таймер времени работы (Uptime Timer):**
  - Добавлен элемент `.uptime-timer` слева от статусбара
  - Формат отображения: `HH:MM:SS`
  - В симуляции: увеличение на 1 секунду каждую секунду
  - В готовой версии: значение `millis()` от Arduino
- Заголовок обновлён: `Moonshine v1.1.8` → `Moonshine v1.1.9`
- Версия обновлена: v1.1.8 → v1.1.9

### v041
- **Таймер времени работы:**
  - `.uptime-timer`: `background` изменён с `#ecf0f1` → `#ffffff` (белый фон)
  - `.uptime-timer`: `border` изменён с `2px` → `1px`
  - `.uptime-timer`: `font-size` увеличен с `15px` → `30px`
- Заголовок обновлён: `Moonshine v1.1.9` → `Moonshine v1.1.10`
- Версия обновлена: v1.1.9 → v1.1.10

### v042 
- **Таймер времени работы перемещён:**
  - Удалён из контейнера схемы (`.scheme-container`)
  - Добавлен в панель сенсоров (`.sensors-panel`) как первая карточка
  - Новый заголовок секции: "Время работы"
  - Стиль оформления: как у карточек температуры/потока (sensor-card)
  - ID элемента: `cardValueUptime` (формат `HH:MM:SS`)
- Заголовок обновлён: `Moonshine v1.1.10` → `Moonshine v1.1.11`
- Версия обновлена: v1.1.10 → v1.1.11

### v043 
- **Таймер времени работы:**
  - Убран заголовок секции "Время работы"
  - Убран подзаголовок карточки "Время от включения"
  - Уменьшена высота карточки таймера (убран отступ заголовка)
  - `margin-bottom: 15px` для отделения от следующей секции
- Заголовок обновлён: `Moonshine v1.1.11` → `Moonshine v1.2.4`
- Версия обновлена: v1.1.11 → v1.2.4
- **Встроен в src/web-ui.cpp** для использования в прошивке

### v043 ✅ (АКТУАЛЬНАЯ)
- **Режим Bold:**
  - Для всех значений датчиков и окна таймера
  - Добавлена кнопка рядом с таймером для переключния. При страте выключена (не запоминается)
- **Встроен в src/web-ui.cpp** для использования в прошивке

---

## История итераций — WiFi Setup UI

### v001 ✅ — Базовый макет
**Файл:** `qwen-wifi_setup.001.html`
**Дата:** 2026-02-25

**Реализованный функционал:**
- ✅ Header с переключателем языков EN/RU
- ✅ Версия устройства в заголовке (ESP Device v1.0.0)
- ✅ Индикатор статуса подключения (🔴🟡🟢)
- ✅ Список WiFi сетей с иконками сигнала и замка
- ✅ Форма ввода пароля с кнопкой показать/скрыть
- ✅ Кнопка Connect для подключения к сети
- ✅ Секция настройки точки доступа (AP SSID и пароль)
- ✅ Кнопки Save & Reboot и Factory Reset
- ✅ Modal dialog для подтверждения сброса
- ✅ Система локализации (EN/RU) с сохранением в localStorage
- ✅ Сортировка сетей по уровню сигнала (RSSI)
- ✅ Валидация пароля (мин. 8 символов)
- ✅ Анимация spinner для загрузки
- ✅ iOS-стиль дизайна (белый фон, закруглённые кнопки, синие акценты)

#### v002 ✅ — Симуляция API и подзаголовок устройства
**Файл:** `qwen-wifi_setup.002.html`
**Дата:** 2026-02-25

**Новый функционал:**
- ✅ Симуляция API для демонстрации (SIMULATION_MODE = true)
- ✅ Генерация 3 сетей FIREFLY* с разным уровнем сигнала (±5 dBm)
- ✅ Пароль для всех сетей: 12345678
- ✅ Подзаголовок устройства в header (тонкий шрифт 13px)
- ✅ Конфигурация deviceConfig для кастомизации (version, subtitle)
- ✅ Симуляция задержек API (800ms scan, 1500ms connect, 1000ms save)
- ✅ Экран перезагрузки после Save & Reboot
- ✅ Экран сброса после Factory Reset

#### v003 ✅ — Улучшение UX и описание устройства
**Файл:** `qwen-wifi_setup.003.html`
**Дата:** 2026-02-25

**Новый функционал:**
- ✅ Контейнер "Selected Network" появляется только при выборе сети из списка
- ✅ Секция с паролем скрывается при переключении фокуса на AP Settings или другие кнопки
- ✅ Зелёная галочка (✅) рядом с замком при успешном подключении к сети
- ✅ Поле description в deviceConfig для дополнительного описания устройства

#### v004 ✅ — Редизайн Selected Network и Disconnect
**Файл:** `qwen-wifi_setup.004.html`
**Дата:** 2026-02-25

**Новый функционал:**
- ✅ Заголовок выбранной сети без поля редактирования (только текст)
- ✅ Горизонтальный разделитель под заголовком сети
- ✅ Кнопка "Connect" переименована в "Join"
- ✅ Кнопка "Disconnect" при подключённой сети (вместо пароля)
- ✅ Автоматическое скрытие поля пароля при подключении
- ✅ Возврат поля пароля после отключения
- ✅ Unicode иконки глаз (👁️/👁️‍🗨️) вместо текста Show/Hide
- ✅ Сброс состояния подключения при выборе новой сети

#### v005 ✅ — Возврат текста Show/Hide и увеличение шрифтов header
**Файл:** `qwen-wifi_setup.005.html`
**Дата:** 2026-02-25

**Изменения:**
- ✅ Возврат текста "Show/Hide" вместо Unicode иконок глаз
- ✅ header-subtitle: увеличен до 17px (было 15px)
- ✅ header-description: увеличен до 14px (было 13px), отступ сверху 4px (было 2px)
- ✅ show-password-btn: шрифт 13px, weight 500 (как было изначально)

#### v006 ✅ — Контейнер информации об устройстве
**Файл:** `qwen-wifi_setup.006.html`
**Дата:** 2026-02-26

**Новый функционал:**
- ✅ Контейнер информации об устройстве (device-info-container) под заголовком
- ✅ Горизонтальный макет: иконка слева, текст справа
- ✅ Иконка устройства по умолчанию (SVG, схематический умный дом)
- ✅ Название устройства (device-name): 20px, Bold, #1C1C1E
- ✅ Описание устройства (device-description): 15px, Regular, #8E8E93
- ✅ Поддержка кастомной иконки через deviceConfig.iconSvg
- ✅ Значения по умолчанию:
  - version: "ESP Device v1.0.0"
  - description: "Устройство для умного дома на базе ESP8266/ESP32"

#### v007 ✅ — Исправление отображения WiFi сетей и иконки
**Файл:** `qwen-wifi_setup.007.html`
**Дата:** 2026-02-26

**Исправления:**
- ✅ Убраны децибелы из отображения уровня сигнала
- ✅ Возвращена информация о типе шифрования (WPA2, Open)
- ✅ Формат отображения: "Хороший • WPA2" (вместо "Слабый • -65 dBm")
- ✅ Зелёная галочка ✅ перемещена к замку (после типа шифрования)
- ✅ Иконка устройства заменена на SVG из icon_smart_device.svg
- ✅ Увеличена версия: v1.0.0 → v1.0.7

#### v008 ✅ (АКТУАЛЬНАЯ) — Исправление положения галочки подключения
**Файл:** `qwen-wifi_setup.008.html`
**Дата:** 2026-02-26

**Исправления:**
- ✅ Зелёная галочка ✅ перемещена прямо перед замочком 🔒
- ✅ Добавлен CSS класс `.network-lock-wrapper` для обёртки
- ✅ Галочка и замок выровнены по центру вертикально (flexbox)
- ✅ Увеличена версия: v1.0.7 → v1.0.8

---

## Структура файлов

```
docs/web-ui/
├── qwen-distillation.043.html    # ✅ АКТУАЛЬНАЯ: Мониторинг дистилляции, встроен в web-ui.cpp, v1.2.10
├── qwen-wifi_setup.008.html      # ✅ АКТУАЛЬНАЯ: Настройка WiFi, v1.0.8
├── icon_smart_device.svg         # SVG иконка умного устройства
├── task_wifi_setup_design.md     # Техническое задание WiFi Setup
├── task_webui.md                 # Техническое задание веб-интерфейса
└── WEB_UI-HISTORY.md             # Этот файл
```

---

*Последнее обновление: 2026-02-26*
