JimorMarlow/Moonshine/(list of files, drawings)

Other design files:
docs/EasyEDA/PCB_PCB_Moonshine.std_2026-02-17.json
docs/EasyEDA/PCB_PCB_Moonshine.std_2026-02-26.json
docs/EasyEDA/SCH_Moonshine.std_2026-02-17.json
docs/EasyEDA/SCH_Moonshine.std_2026-02-26.json
