JimorMarlow/Moonshine/(commit log)

2026-01-16 v0.0.2 - измерение температуры
2026-01-17 v0.0.3 - Исправил опрос температуры, датчики можно переключать на ходу
    [main.cpp, pinout.h, sensor_t.cpp, sensor_t.h, settings.cpp, settings.h, version.h]
2026-01-17 v0.0.4 Подключил LCD 2004 для вывода температуры и времени работы Добавил медианный (median3) фильтр для сглаживания температуры
2026-01-18 v0.0.5 - Изменил пины подключения, допаял колодку подключения
2026-01-21 links to example valve control with stepper motor
2026-01-26 v0.0.6-0.0.10 - Собрал первую рабочую схему с полным набором датчиков
2026-02-10 readme connectors upd
2026-02-17 v 1.0.10 web-ui макер, EasyEDA для PCB, небольшие изменения в коде (украшательства)
2026-02-17 upd к предыдущему комиту
    [PCB_PCB_Moonshine.std_2026-02-17.json, SCH_Moonshine.std_2026-02-17.json]
2026-02-19 Обновлена HISTORY.md (v032) и добавлена инструкция по установке Qwen Code
2026-02-19 Web UI: откат к v029, удалены проблемные итерации (v030-v034)
2026-02-19 v1.0.31 Web UI v033: обновлён контейнер схемы
2026-02-19 Переименовал историю WEB_UI-HISTORY.md
2026-02-20 v1.1.6 web-ui макет с горизонтальной и вертикальной ориентацией
2026-02-24 v1.1.12 web ui - Таймер: компактный вид без заголовков
2026-02-24 v.1.2.0 задание на разработку web-ui
2026-02-24 v1.2.1 web-UI первая реализация (QWEN 3.5)
2026-02-24 v1.2.2 web-ui, show temperatures, non tested yet
2026-02-25 v1.2.3 Исправление mDNS
2026-02-26 v1.2.4 Почистил историю макета web-ui, разработка окна настройки wi-fi для устройства
2026-02-26 v1.2.4 web-ui Увеличенный фонт для мобильной версии
2026-02-26 v1.2.5 feat(web-ui): Bold-кнопка и мониторинг подключения в прошивке, (EasyEDA): добавлена кнопка для размещения на плате
    [PCB_PCB_Moonshine.std_2026-02-26.json, SCH_Moonshine.std_2026-02-26.json]
2026-02-26 v1.2.9 moonshine_web_server - рефакторинг
2026-02-26 v.1.2.10 Макет страницы настройки wi-fi (qwen-wifi_setup.008.html)
2026-02-26 v1.2.11 etl::wifi::wifi_setup - первая реализация по макету, не проверено
2026-02-26 v1.2.12 почищена история, добавлены реакции на кнопки при старте
2026-03-02 v1.2.13 Класс wifi_setup переименован в server_setup
2026-03-02 v1.2.14 web server для настройки wi-fi, иконка svg для moonshine
2026-03-02 v1.2.15 Добавлена поддержка mDNS в класс etl::wifi::server_setup
2026-03-02 ArduinoJson - deprecated fix
    [etl_wifi_setup.cpp]
2026-03-02 v1.2.16 Замена сырого указателя на etl::shared_ptr в server_setup
    Изменения в etl::wifi::server_setup:
    - Замена ESP8266WebServer* на etl::shared_ptr<ESP8266WebServer>
    - Использование etl::make_shared для создания сервера
    - Автоматическое управление памятью через reset() в stop()
    - Добавлен include <etl/etl_memory.h>
    [etl_wifi_setup.cpp, etl_wifi_setup.h, version.h]
2026-03-03 v1.2.18 Расчет минутного расхода воды
2026-03-03 v1.2.19 WiFi setting connected, flow rate calc
2026-03-04 v1.2.20 Рефакторинг flow_sensor_t: struct → class
2026-03-04 docs/qwen_make_no_mistakes.md создан с правилами: ✅ Запрет на галлюцинации API ✅ Требование останавливаться и спрашивать при неуверенности ✅ Обязательная пометка // FIXME / // WARNING для сомнительно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
2026-10-21 Flow Sensor adator to tube 8x12mm
2026-10-21 Flow sensor adater update
2026-10-22 moving to esp32 + wokwi scheme
2026-10-27 STL adater updated to v3
2026-10-28 v1.3.0 added esp32 config... starting...
2026-10-28 v1.3.1 web-ui - updated to ESP32/ESP8266 compatibility (not tested yet)
2026-10-29 10pin cable pinout
